lxp1413801/cs66b-redo/电信nbiot平台接入流程.docx

电信nbiot平台接入流程：

1、 开通实验室环境平台账号（已完成）；
2、 编写profile文件以及编解码插件（电信提供技术支持）；
3、 上传编解码插件（电信提供技术支持）；
4、 测试profile和编解码插件（用虚拟设备自测，或者是仪表发送测试数据）；
5、 平台接入测试（电信nbiot上海研究院，远程测试），通过测试后发测试报告；
6、 下载电信平台的北向接口说明书（开通账号的时候可能已经有了），并开发自己服务器（云主机）和app；
7、 如果客户自有的服务器或者是客户自己租用服务器，每个客户单独部署；
8、 客户数据统一由一个服务器托管，通过不同的账号区别每个客户的数据；
