lxp1413801/cs66b-redo/sch/CS66无线扩展板电子元器件清单.xlsx

CS66无线扩展板电子元器件清单
序号 | 型号名称 | 数量 | 位号 | 封装 | 备注
19 | 0Ω贴片电阻 | 2 | R16、C13 | 0603
23 | 10Ω贴片电阻 | 1 | R17 | 0603
25 | 33Ω贴片电阻 | 3 | R13-15 | 0603
21 | 100欧姆贴片电阻 | 4 | R8-9 R24-25 | 0603
24 | 1K贴片电阻 | 4 | R3 R11 R20 R30 | 0603
22 | 10K贴片电阻 | 8 | R4-5 R7 R12 R22 R26-28 | 0603
20 | 100K贴片电阻 | 5 | R2 R10 R19 R21 R29 | 0603
18 | 1Ω贴片电阻 | 2 | R1 R18 | 1206
9 | 30pF贴片电容 | 3 | C7-9 | 0603
5 | 100pF贴片电容 NPO | 2 | C3 C19 | 0603
4 | 0.1uF贴片电容 | 3 | C4-5 C18 | 0603
8 | 1uF贴片电容 10VDC | 2 | C6 C12 | 0603
6 | 10uF贴片电容 16VDC | 4 | C1-2 C16-17 | C1206
14 | 47nH贴片绕线电感 | 1 | L1 | 0603 | 参考型号： B82496C3470G000（TDK）
2 | 场效应管AO3400 | 2 | T2 T4 | SOT23
1 | 场效应管AO4066 | 2 | U6-7 | SOP8
17 | 集成电路,MCP1703T-3302E/MB | 2 | U3 U13 | SOT89
10 | 集成电路CD4066 | 1 | U4 | TSSOP14
13 | 贴片SIM卡 | 1 | U2 | ESIM_MFF2
3 | NBiot模组BC95 | 1 | U1 | BC95
16 | GPS模组L70 | 1 | U5 | L70
11 | 2.54排针6P | 1 | CON2 | SIP-6P
12 | 2.54排针8P | 1 | CON1 | SIP-8P
15 | IPEX射频插座2.0mm | 2 | CON3-4 | IPEX20369 | 参考型号: MM5829-2700（murata）
