lxp1413801/cs66b-redo/sch/CS66.V3.0.SCH.LCD等.dxf

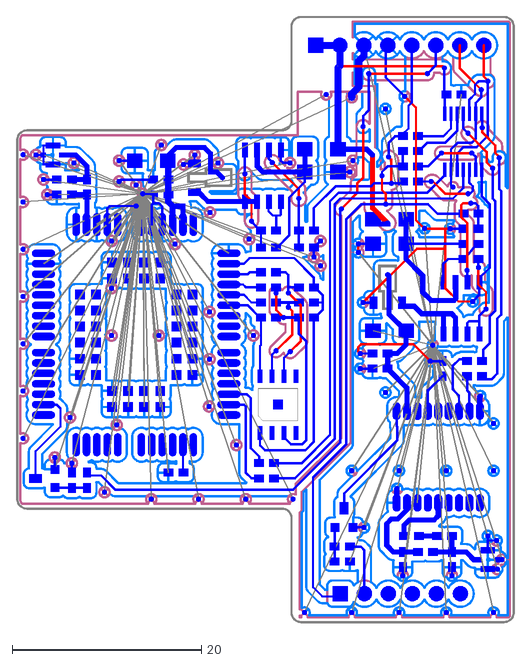
[picture p2: CAD file, 2018-04-26]
sch/CS66.V3.0.SCH.LCD等.dxf
52.7 x 64.2
