lxp1413801/cs66b-redo/sch/pads lib/dxf/esim_mff2.dxf

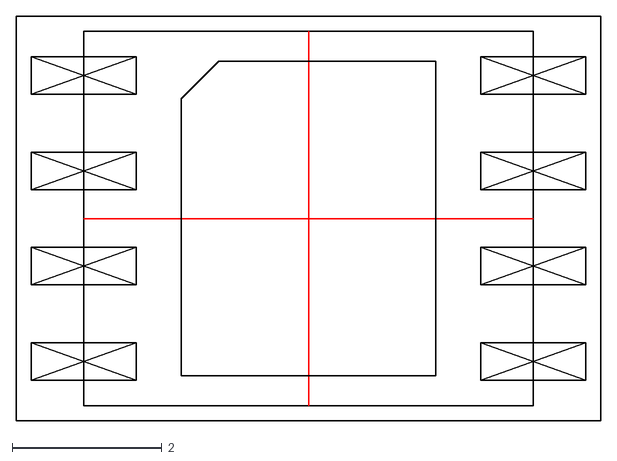
[picture p3: CAD file, 2018-02-05]
sch/pads lib/dxf/esim_mff2.dxf
7.80 x 5.40
