lxp1413801/cs66b-redo/sch/pads lib/dxf/esim.dxf

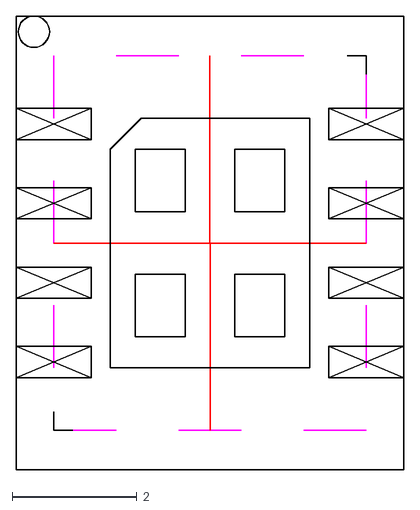
[picture p4: CAD file, 2018-02-02]
sch/pads lib/dxf/esim.dxf
6.20 x 7.27
