lxp1413801/cs66b-redo/sch/pcb out line.dxf

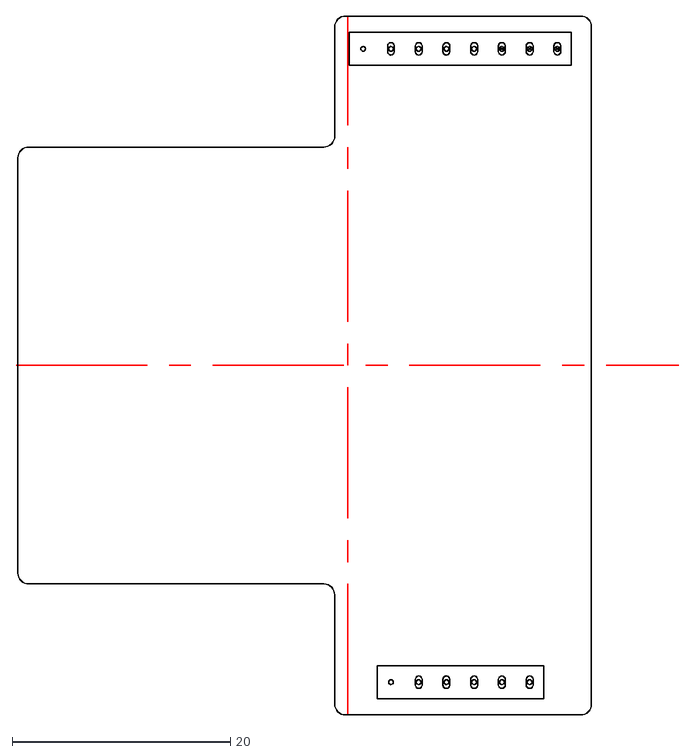
[picture p5: CAD file, 2018-02-08]
sch/pcb out line.dxf
60.7 x 64.0
