lxp1413801/cs66b-redo/sch/pads lib/dxf/ipex20369.dxf

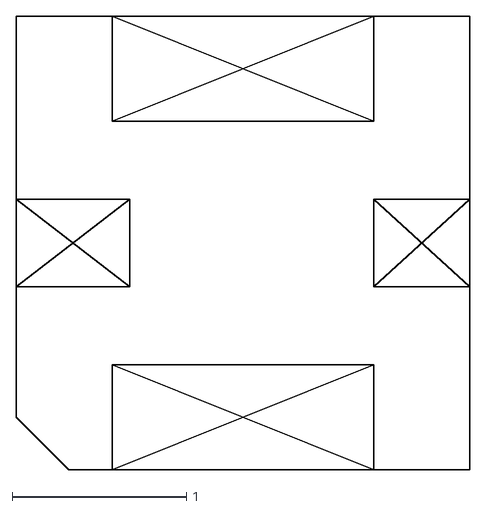
[picture p6: CAD file, 2018-02-02]
sch/pads lib/dxf/ipex20369.dxf
2.60 x 2.60
