lxp1413801/cs66b-redo/sch/CS66.ZB.V3.0.dxf

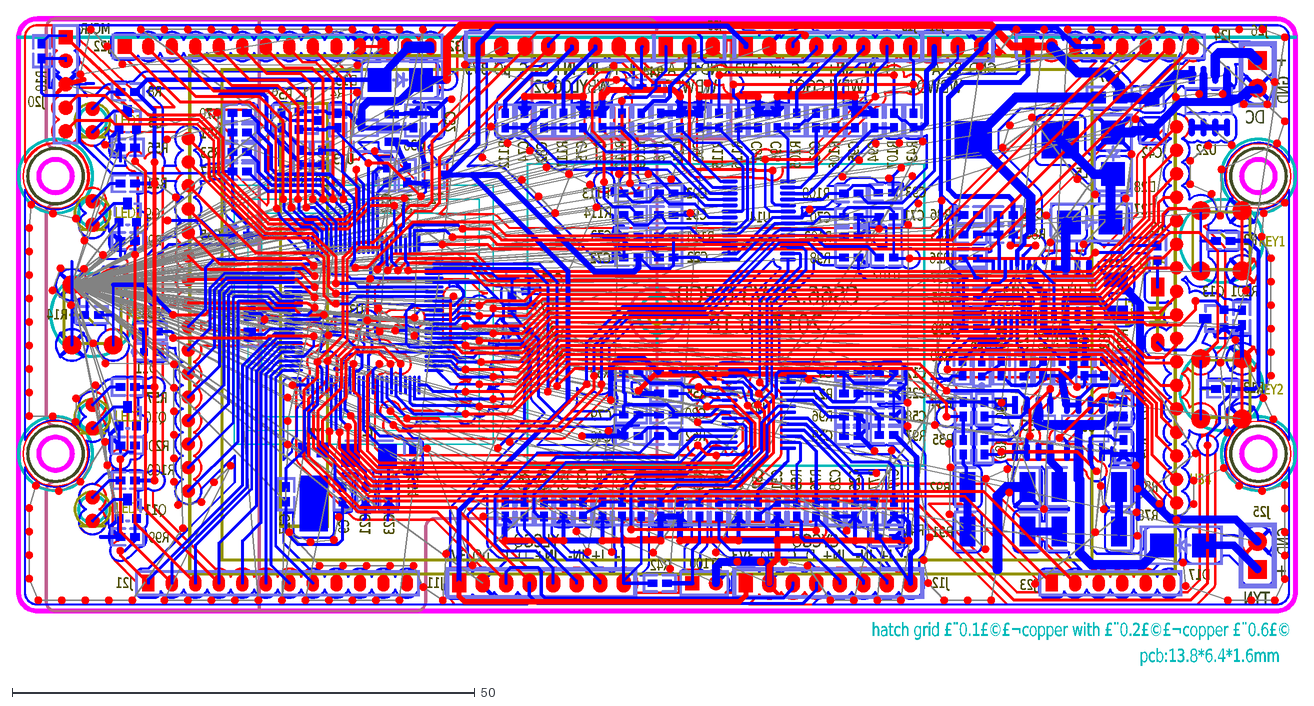
[picture p7: CAD file, 2018-02-05]
sch/CS66.ZB.V3.0.dxf
hatch grid （0.1），copper with （0.2），copper （0.6）
pcb:13.8*6.4*1.6mm
CS66.ZB.V3.0.PCB
2017.10.18
CYCGQ
YLCGQ
WBWD2
背光
TYN
DC
+
GND
MCLR
3V3
地
C
D
IN+
IN-
I+
I-
WBYLCGQ2
WBYLCGQ1
WBWD1
A
B1
LED3
LED2
LED1
LED4
KEY3
LED5
U34
KEY2
KEY1
Y1
R18
J20
R14
J22
R99
R100
R20
R57
R9
R11
R56
R8
Q11
Q10
Q9
Q3
J21
D11
R31
C45
R17
R53
R61
R70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
