lxp1413801/cs66b-redo/sch/pcb out line_v101.dxf

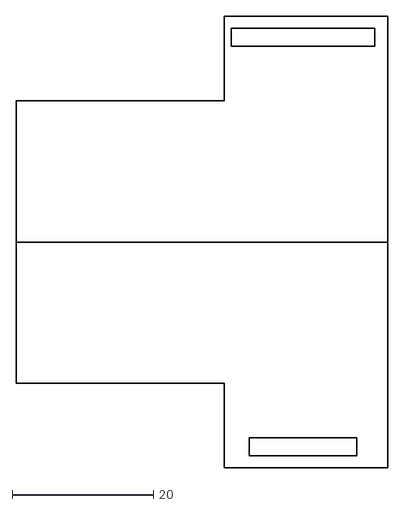
[picture p8: CAD file, 2018-02-06, an earlier design]
sch/pcb out line_v101.dxf
52.7 x 64.0
