lxp1413801/cs66b-redo/CS66.V3.3.SCH.pdf

D

6 | 5 | 4 | 2 | 1

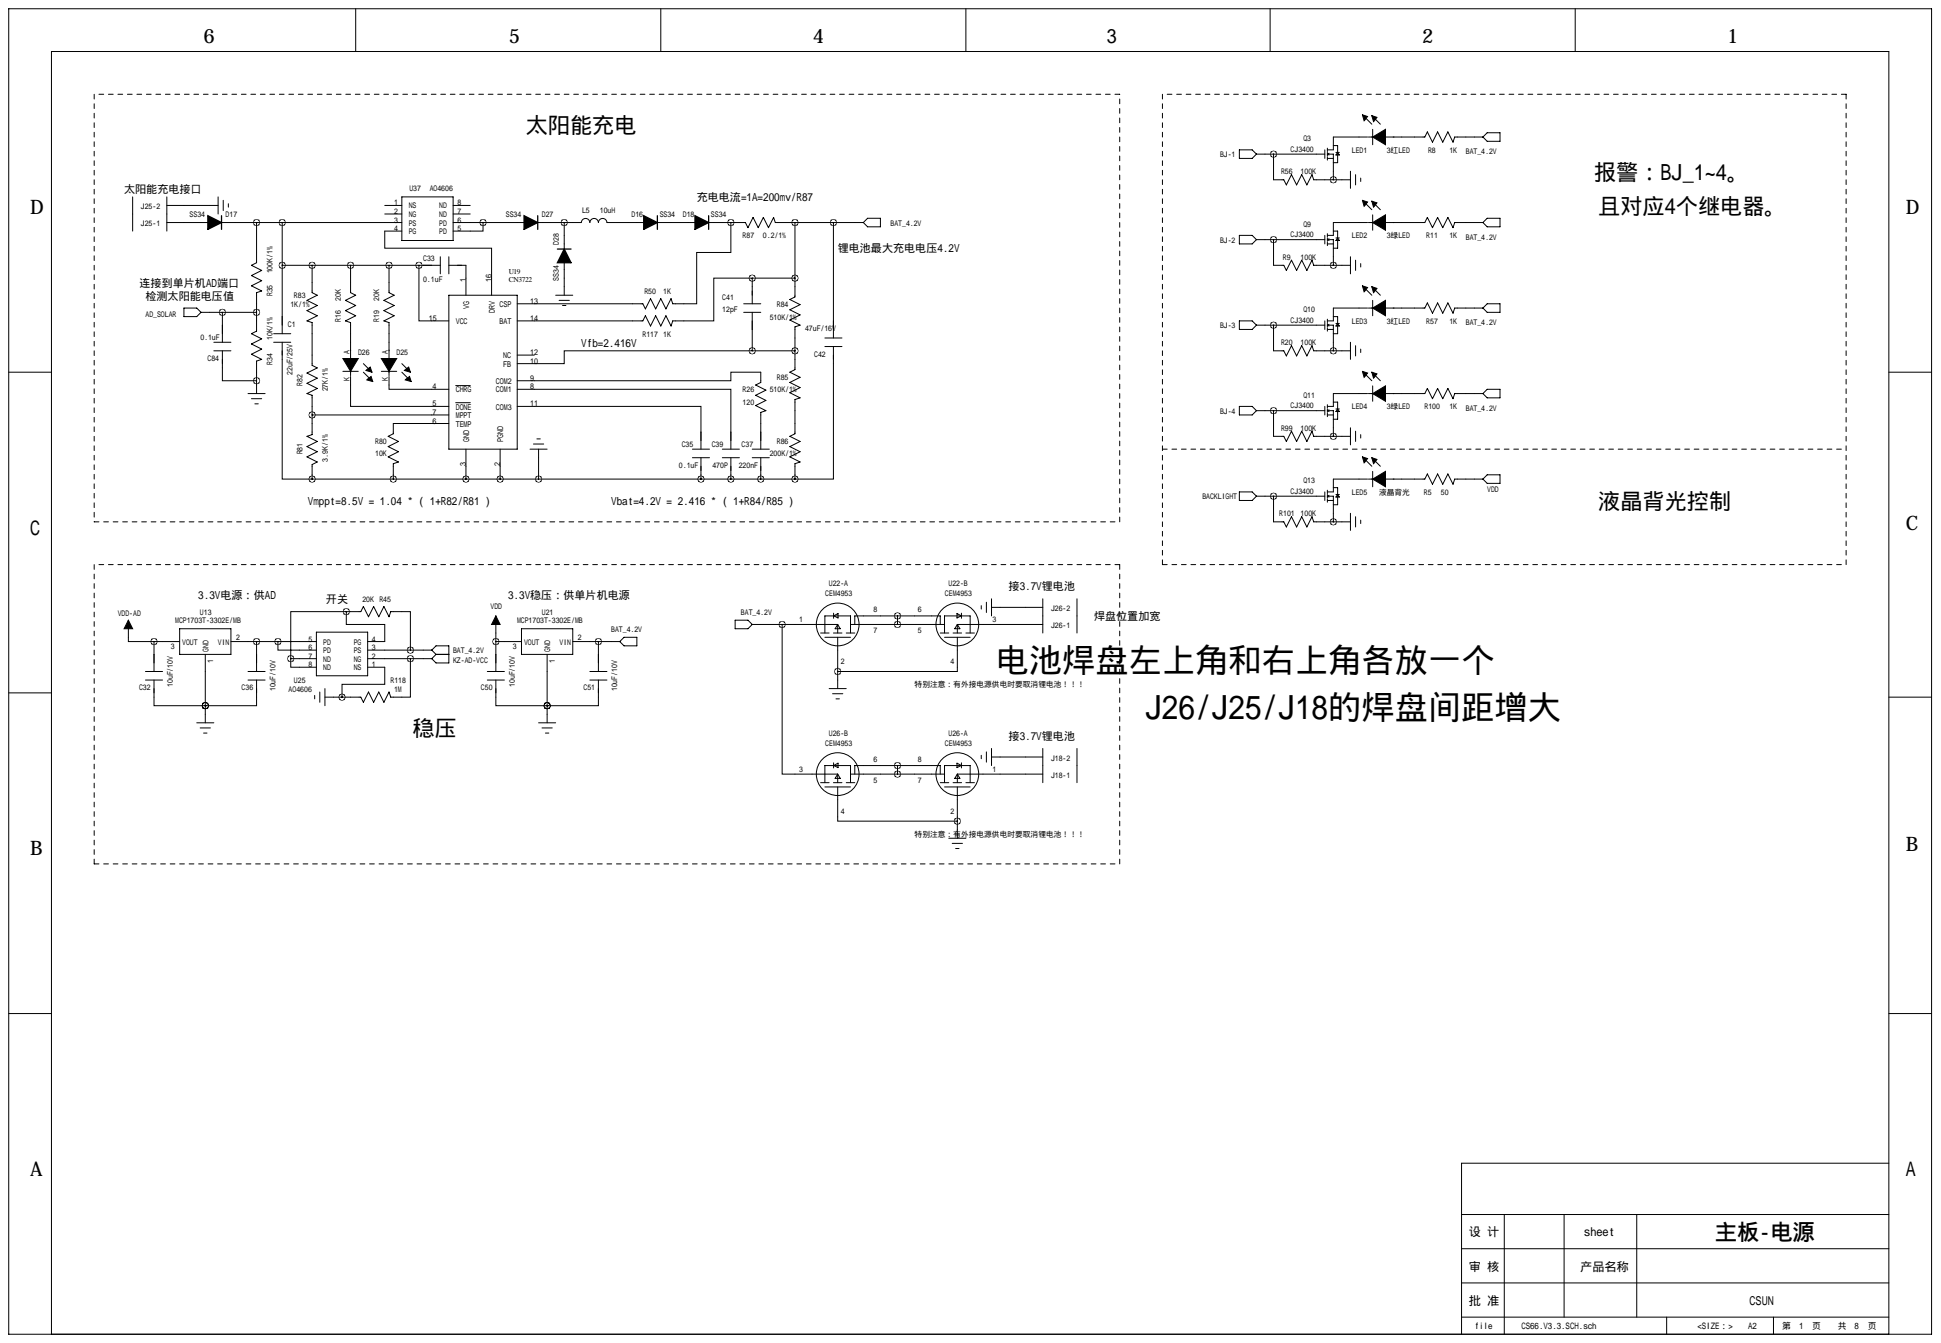
[picture p9: page 1]

设 计 | | sheet | 主板-电源

审 核 | | 产品名称

批 准 | | | CSUN

file | CS66.V3.3.SCH.sch | <SIZE：> A2 | 第 页 共 页

D

D

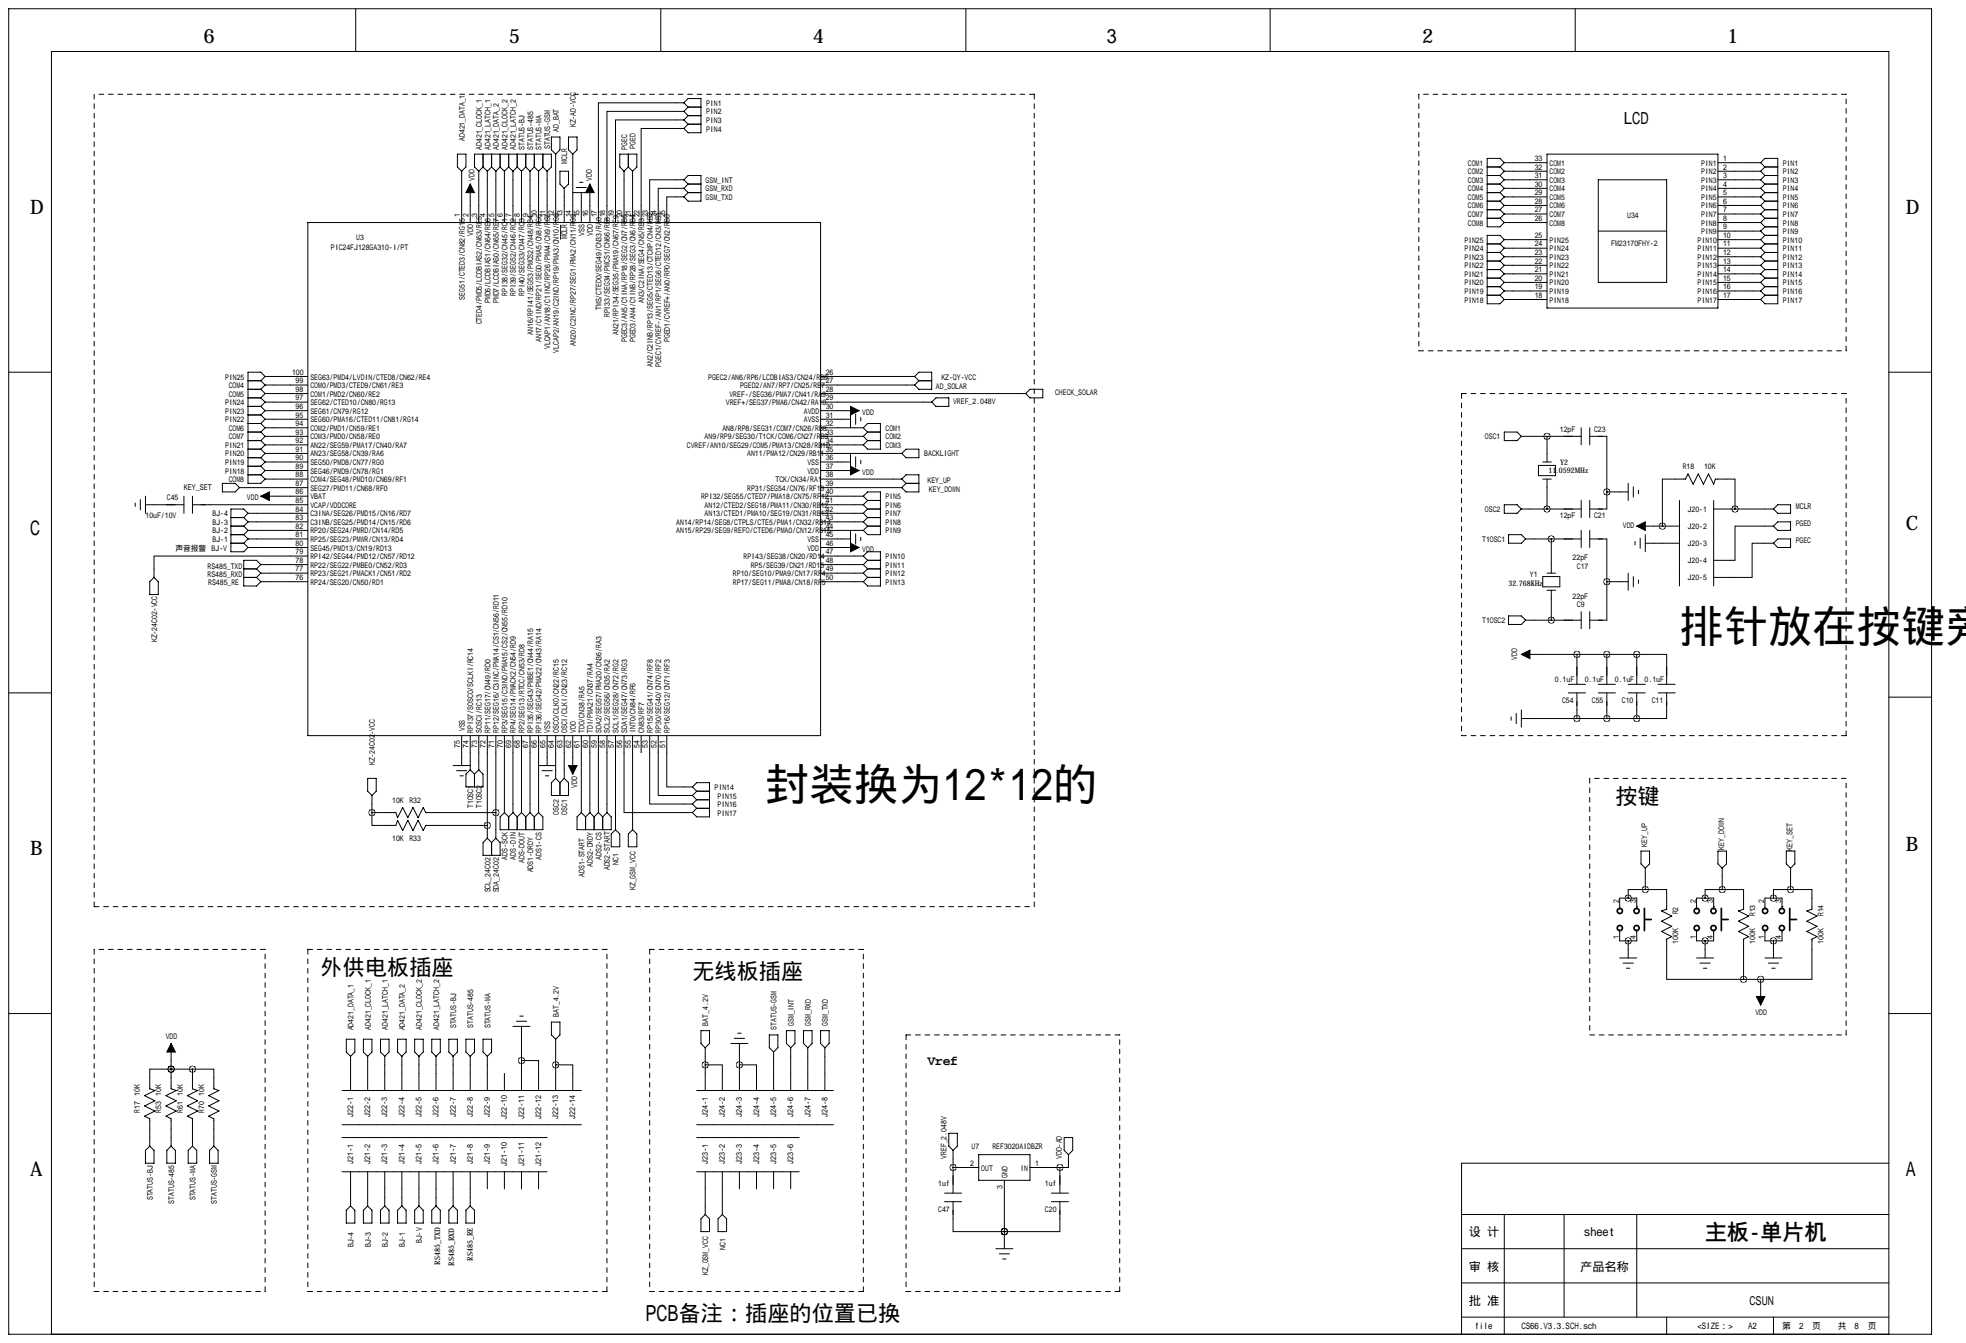
[picture p10: page 2]

D

D

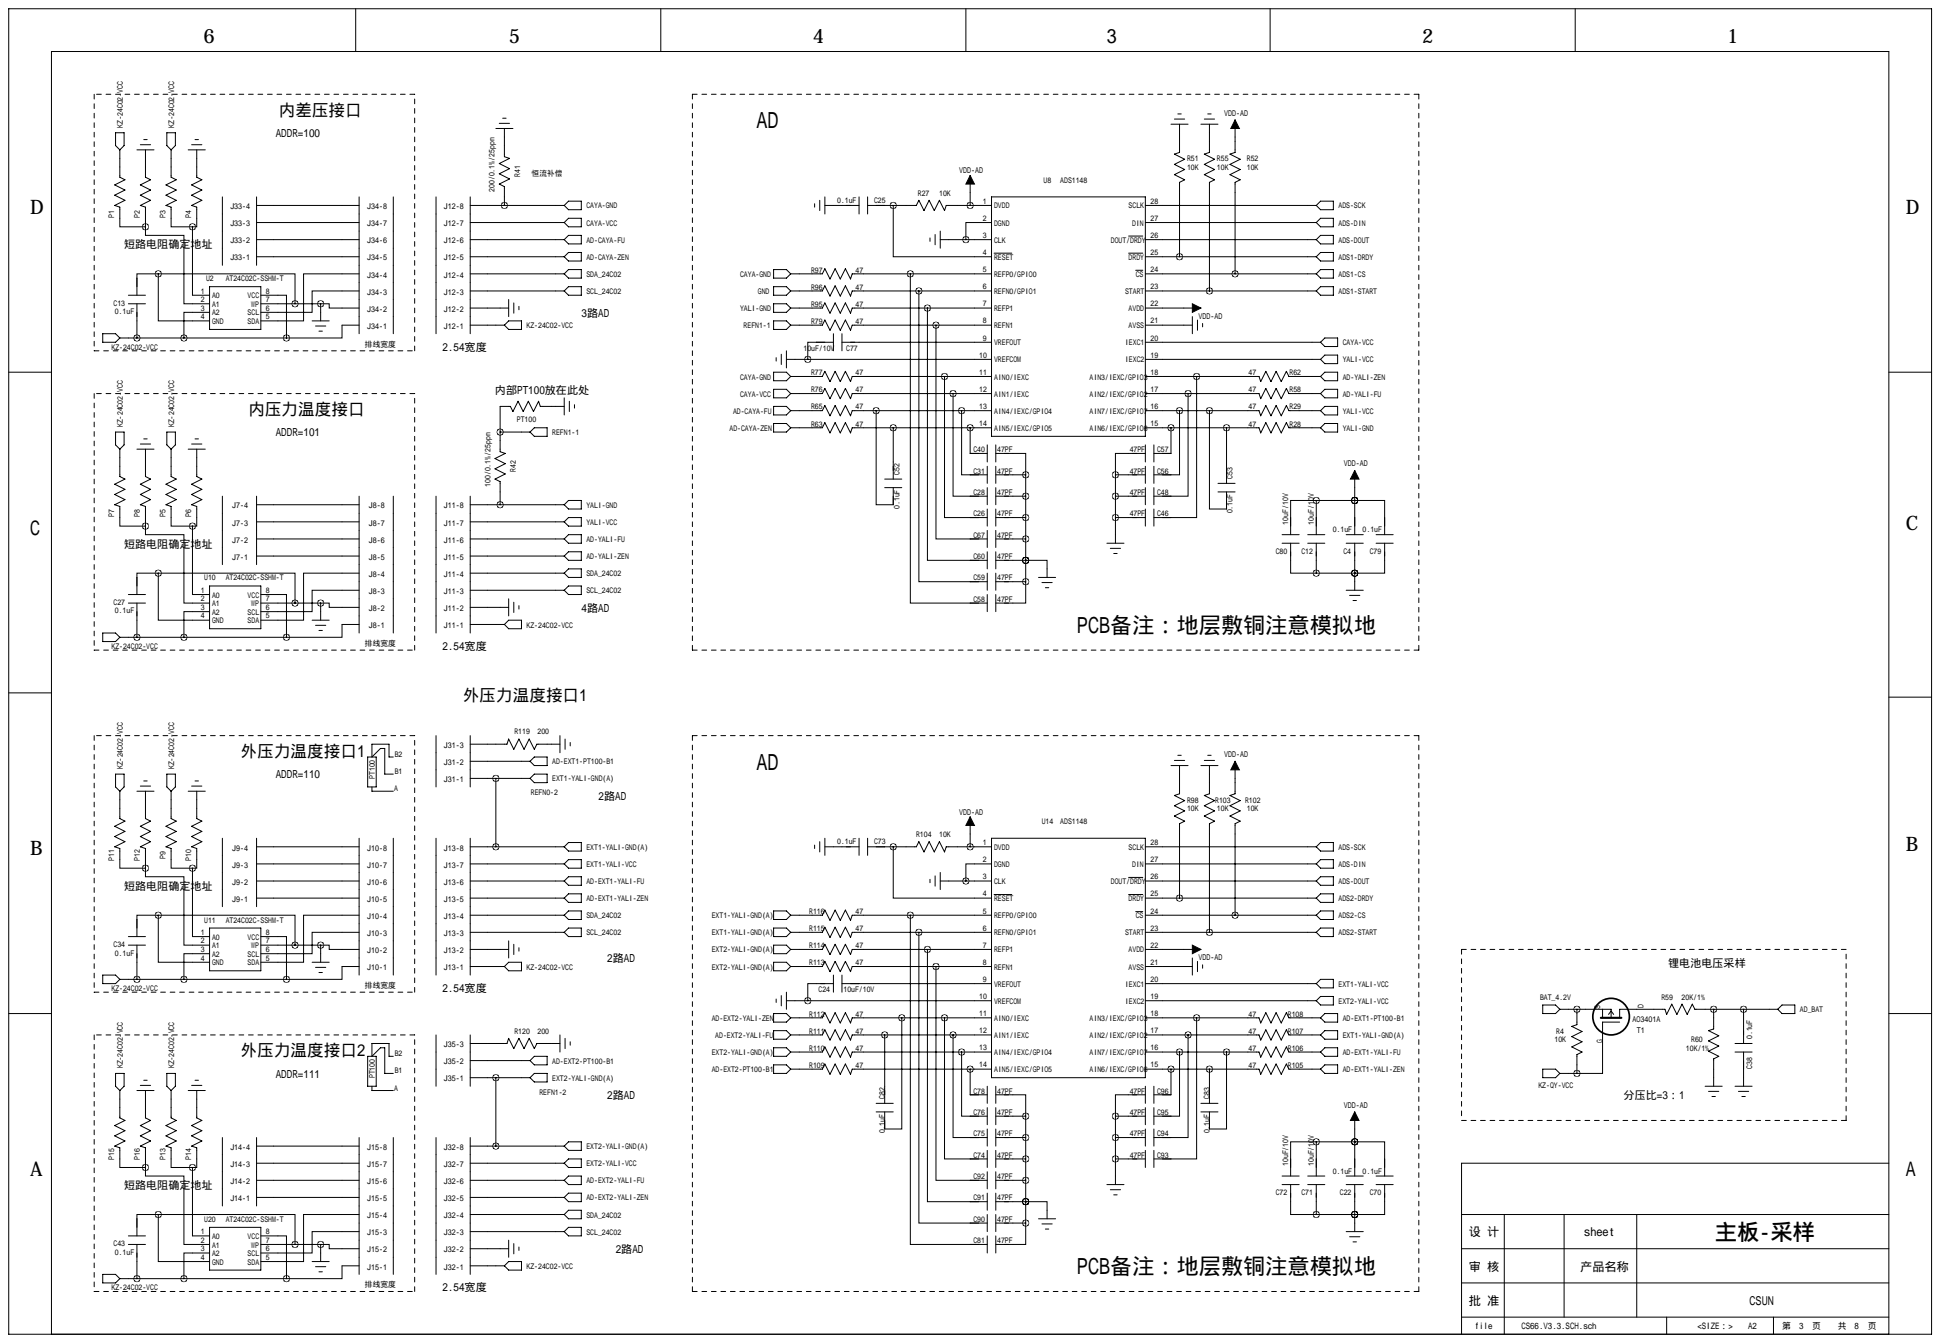
[picture p11: page 3]

D

D

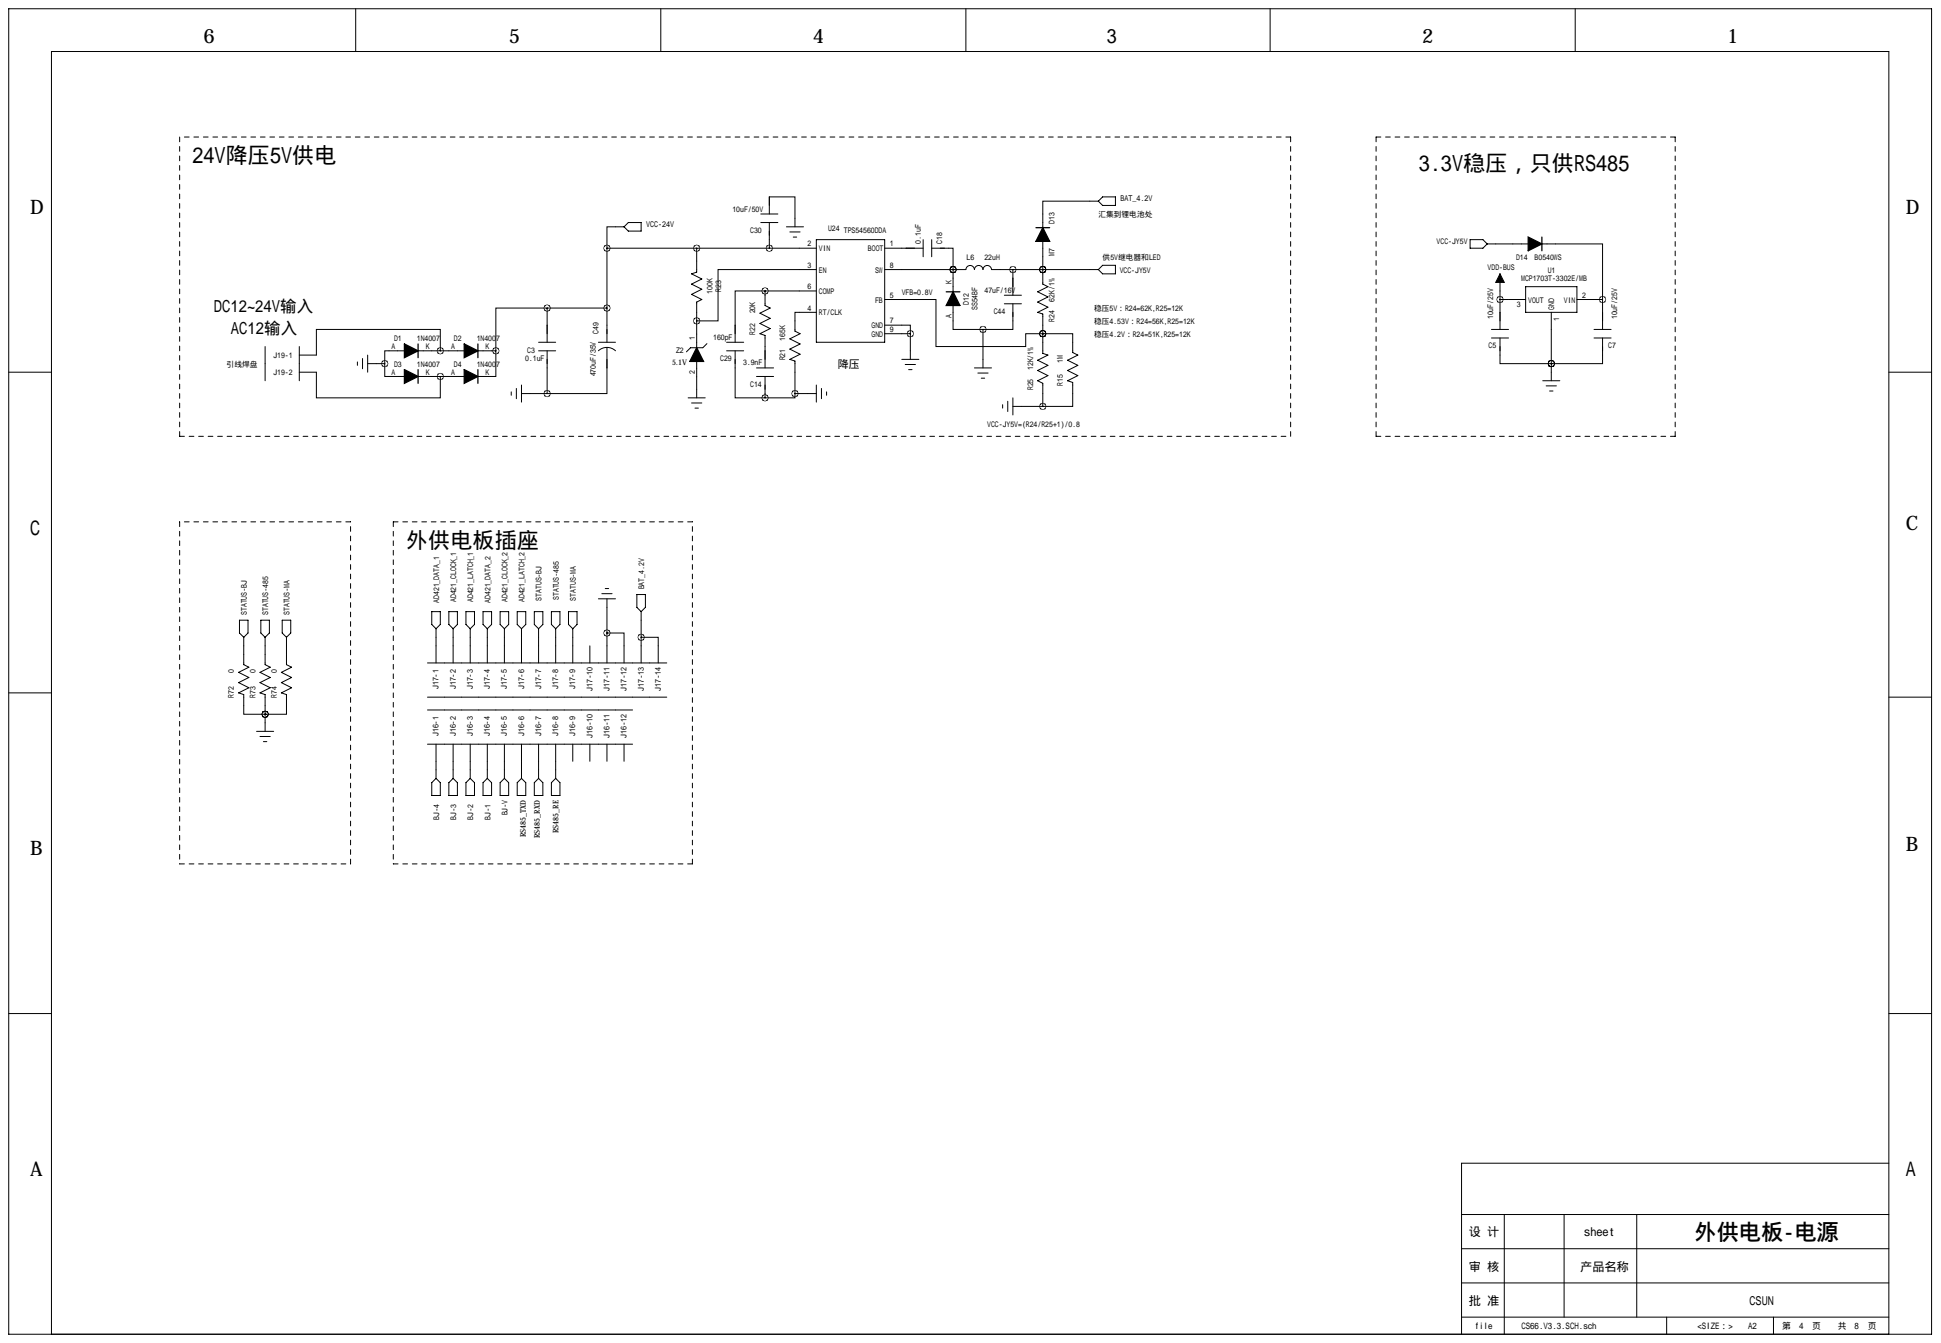
[picture p12: page 4]

D

D

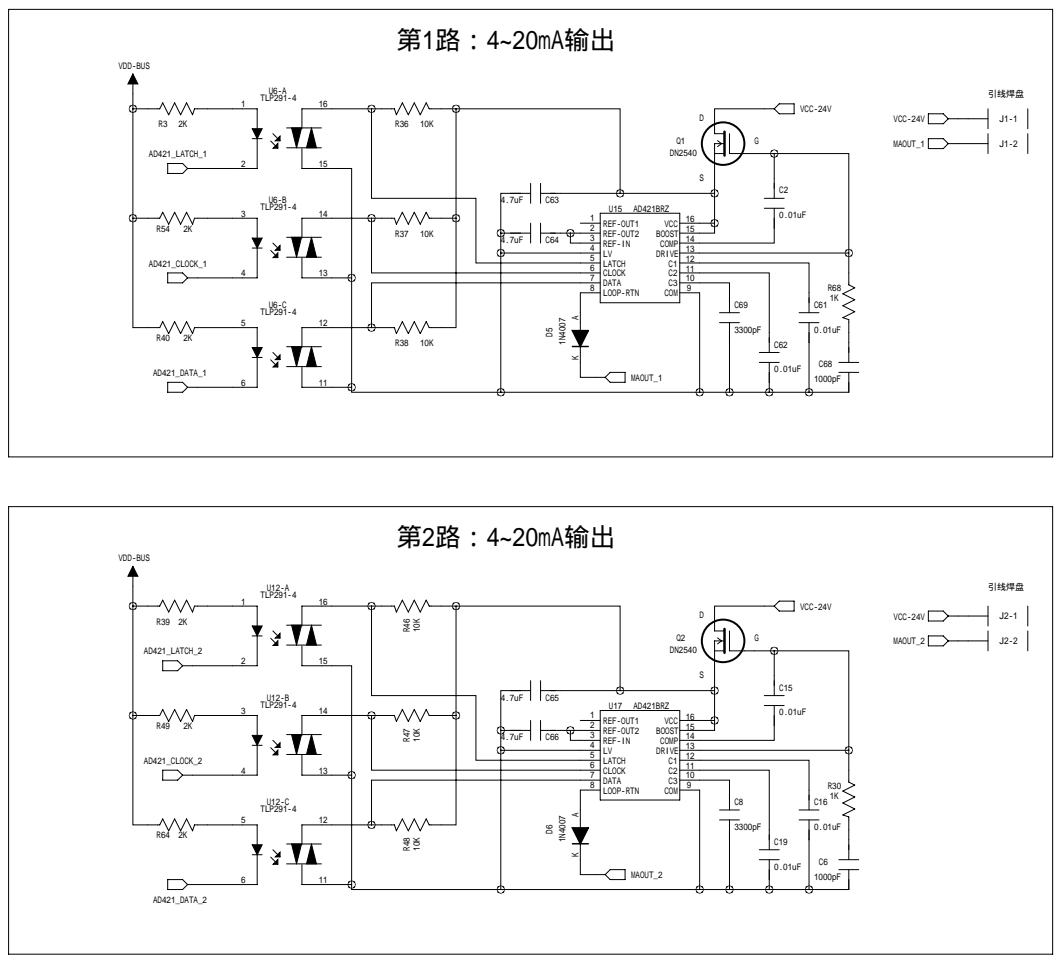
[picture p13: page 5]

D

D

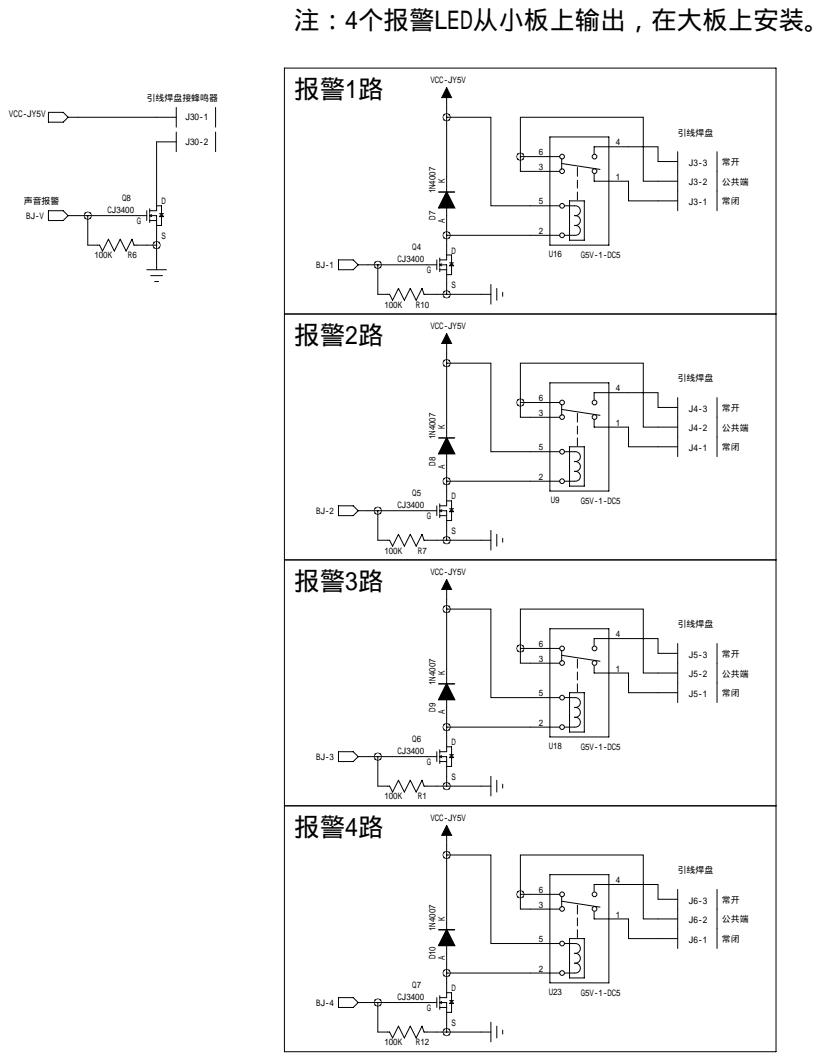
[picture p14: page 6]

D

D

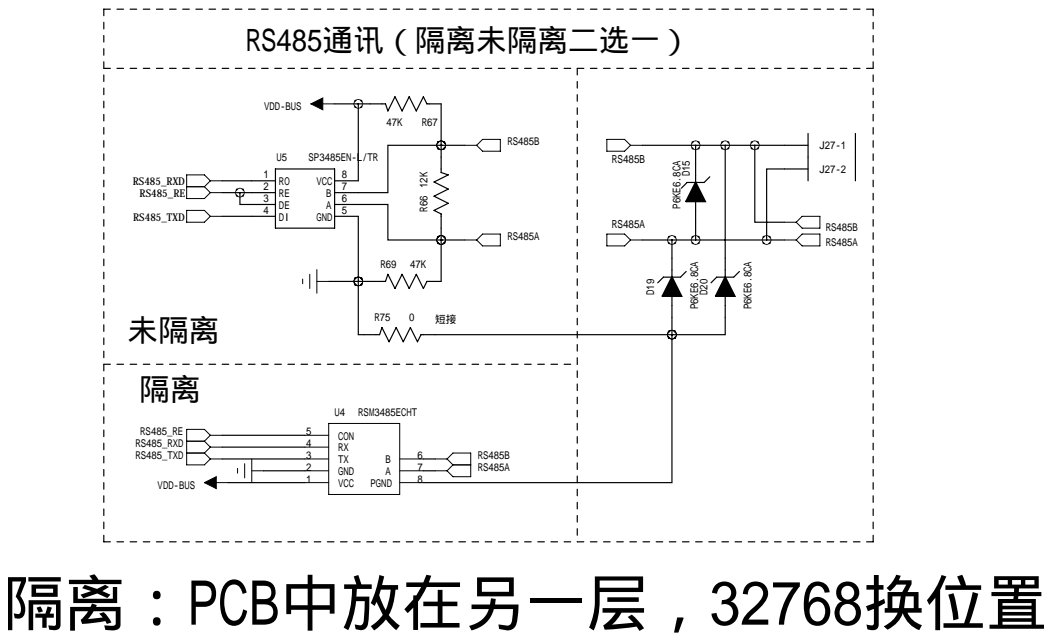
[picture p15: page 7]
sheet; 外供电板-485; RS485通讯（隔离未隔离二选一）; 未隔离; 隔离：PCB中放在另一层，32768换位置; VCC; GND; CON; PGND; RSM3485ECHT; VDD-BUS; RS485_RE RS485_RXD RS485_TXD; RS485_TXD; RS485_RXD

D

D

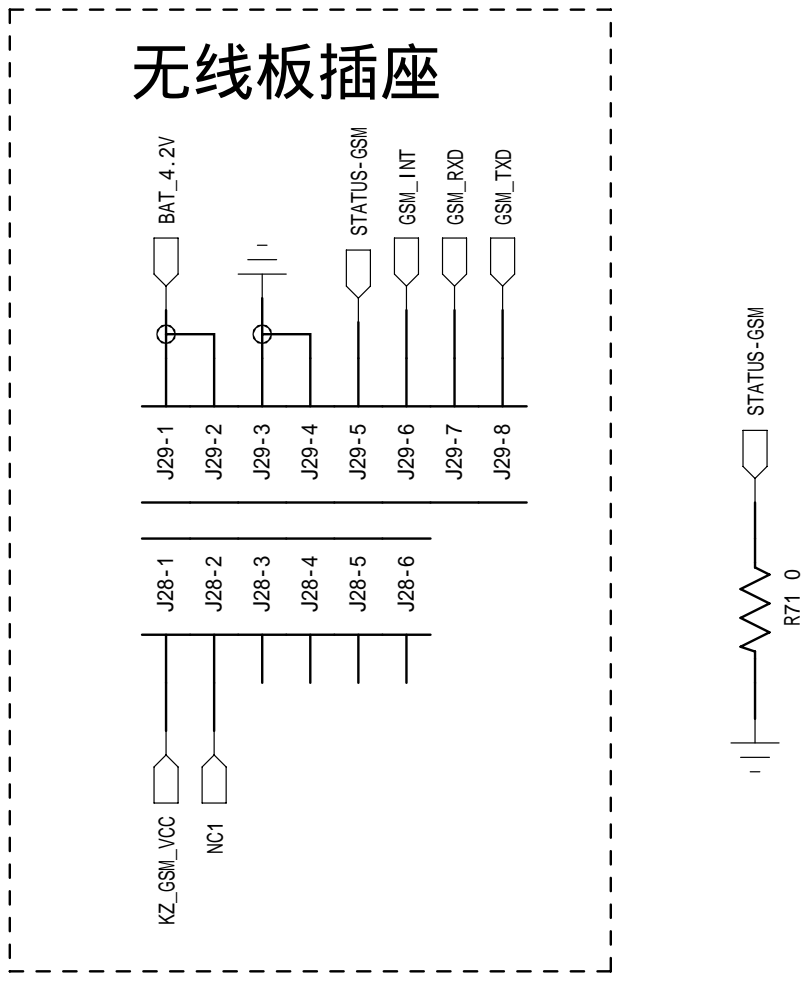
[picture p16: page 8]
sheet; 无线板-GPRS; 无线板插座
