lxp1413801/cs66b-redo/sch/CS66.V3.0.SCH.LCD等.pdf

D

6 | 5 | 4 | 3 | 2 | 1

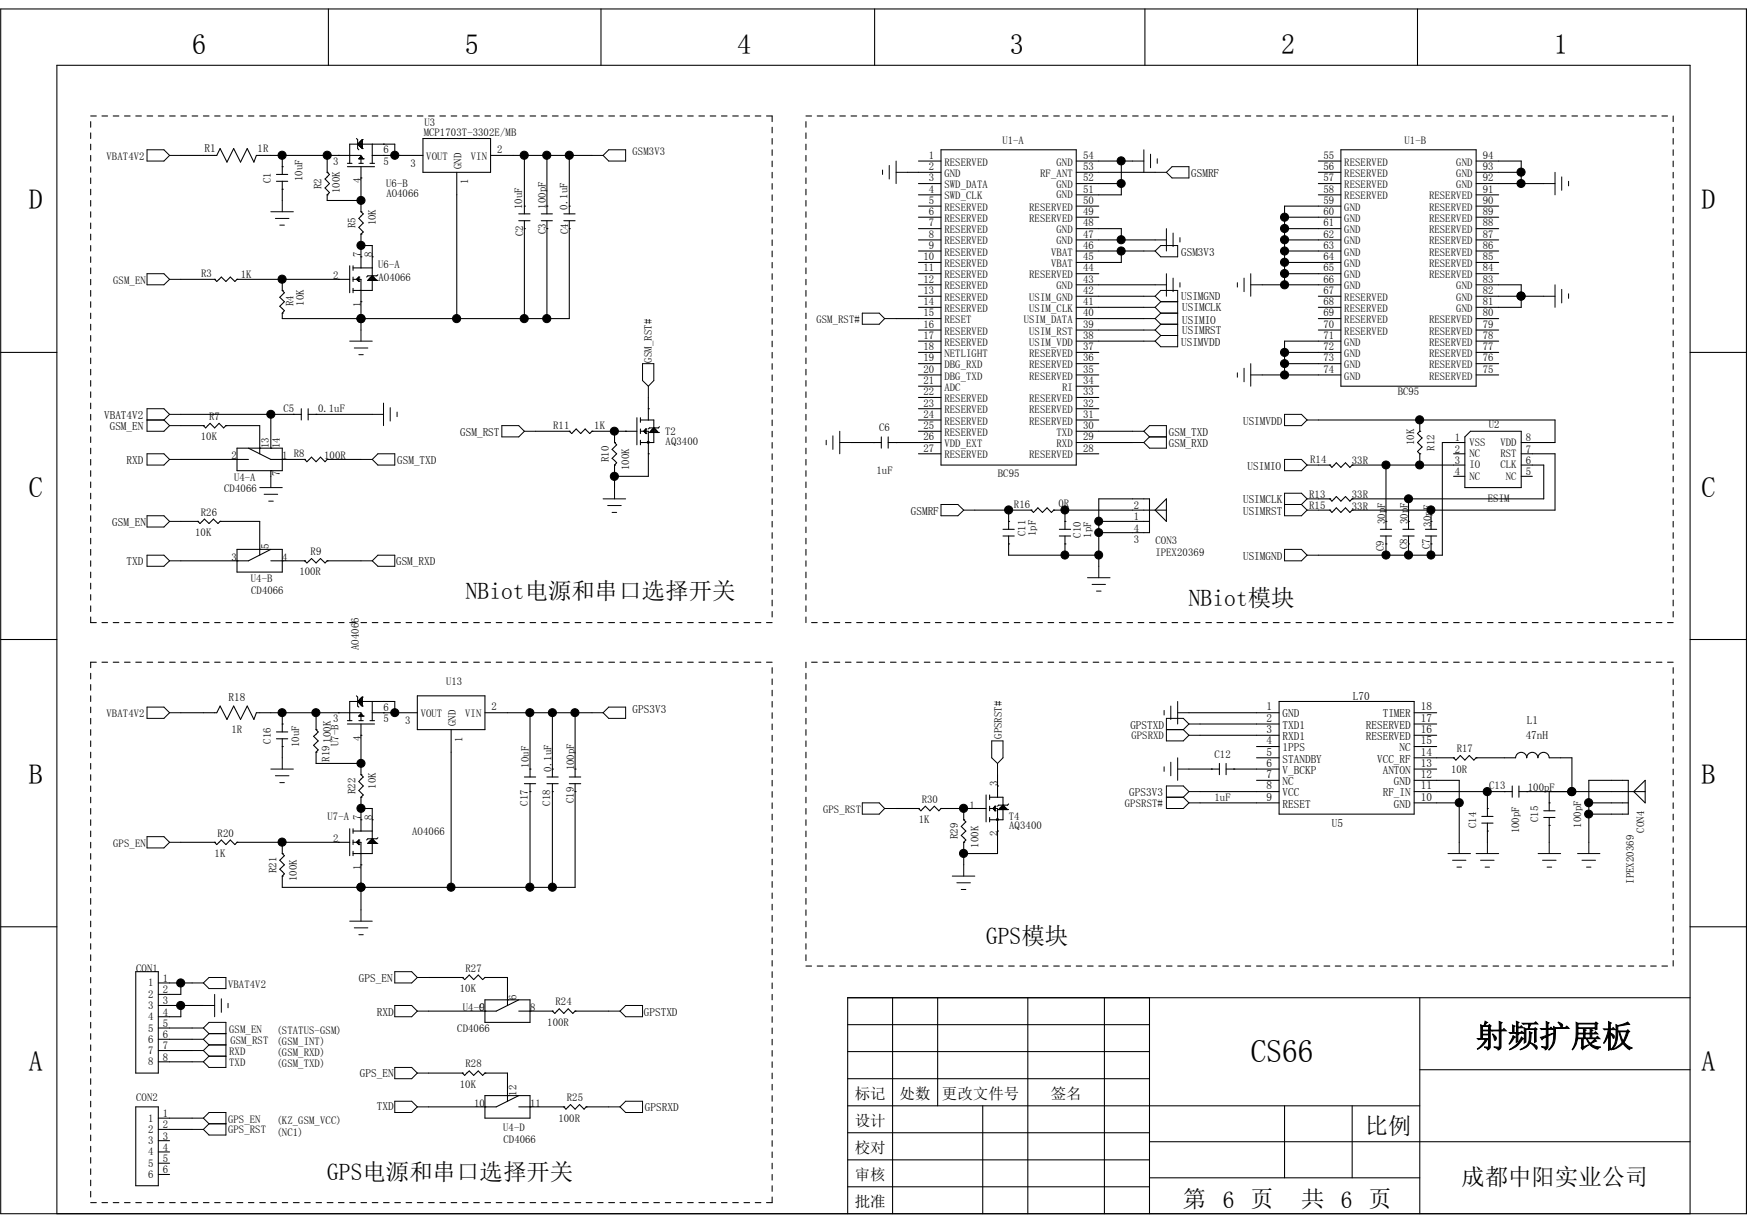
[picture p24: page 1]

校对
审核
批准

成都中阳实业公司
