lxp1413801/cs66b-redo/sch/CS66.V3.0.SCH.LCD等pcb.pdf

# C5C⁵x1 C⁵x2


CON2 CON²x1 CON²x2 CON²x3 CON²x4 CON²x5 CON²x6; CON1 CON¹x1 CON¹x2 CON¹x3 CON¹x4 CON¹x5 CON¹x6 CON¹x7 CON¹x8

C5

# C5C⁵x1 C⁵x2



1 | 2 | 3 | 4 | 5 | 6 | 7 | 8
1 | 2

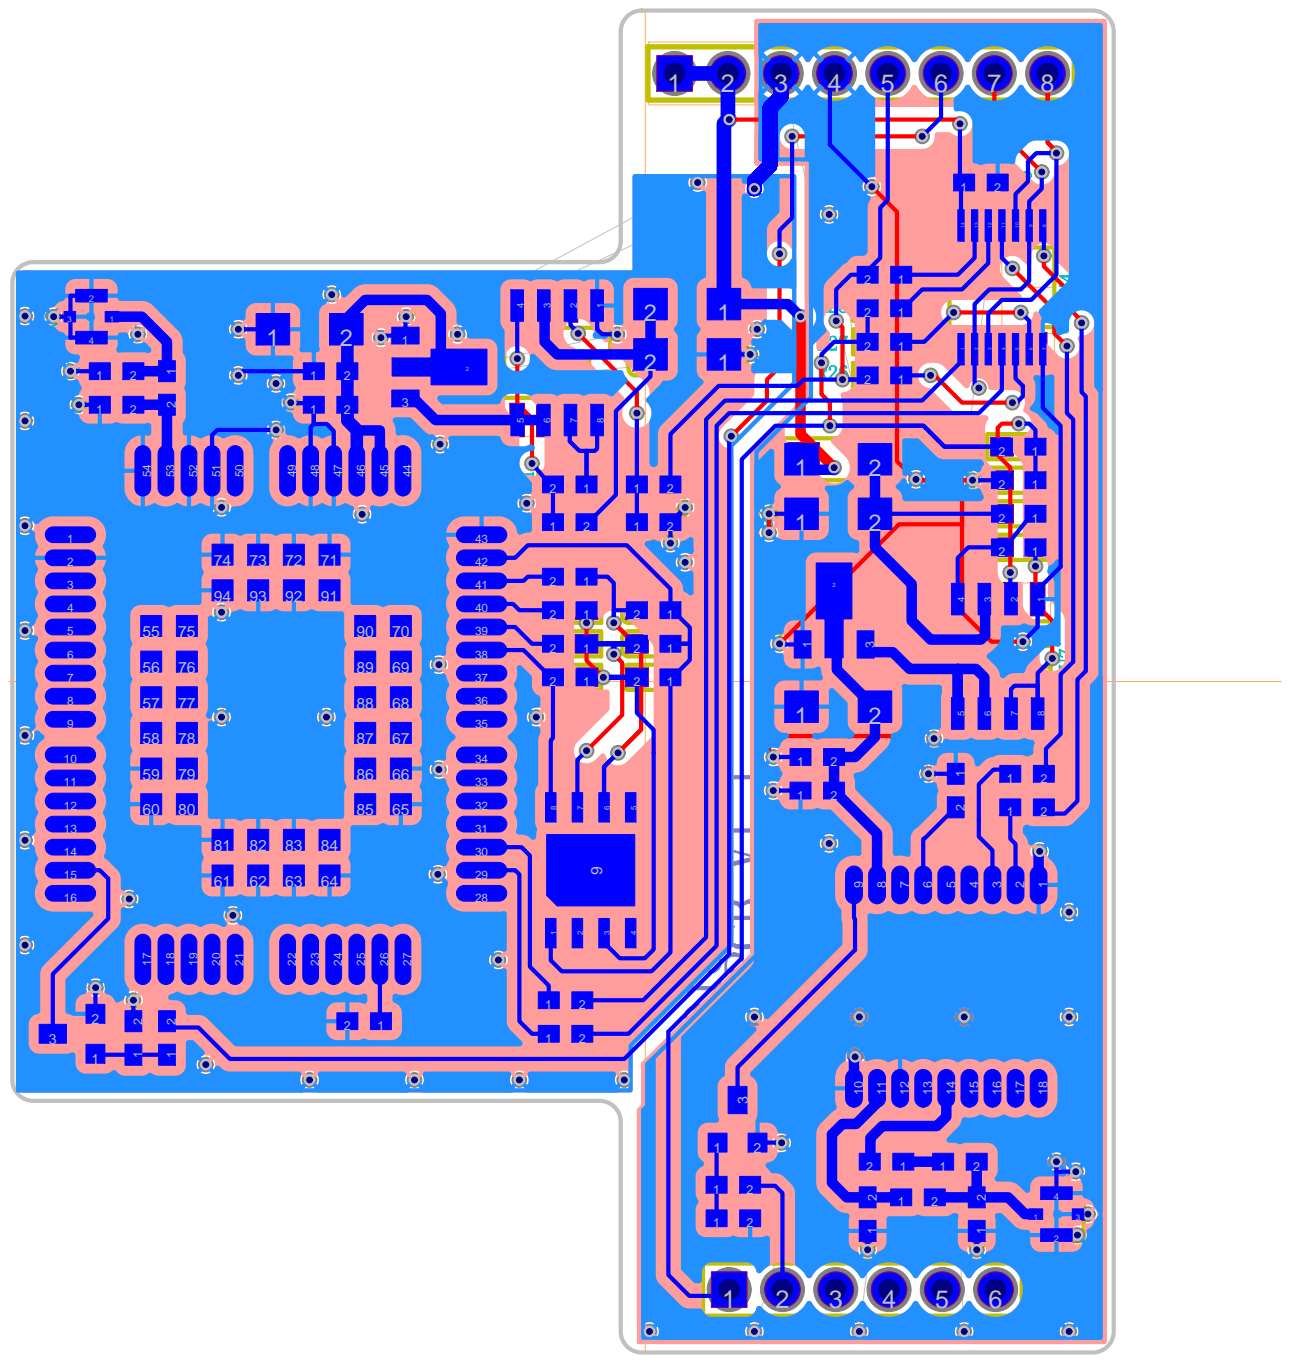
[picture p25: page 5]

C11C¹¹x1 C11C¹¹x1 C11C¹¹x1 | C¹¹x2 C¹¹x2 C¹¹x2 | C4C⁴x1 C4C⁴x1 C4C⁴x1 | C⁴x2 C⁴x2 C⁴x2 2

C5

# CON1

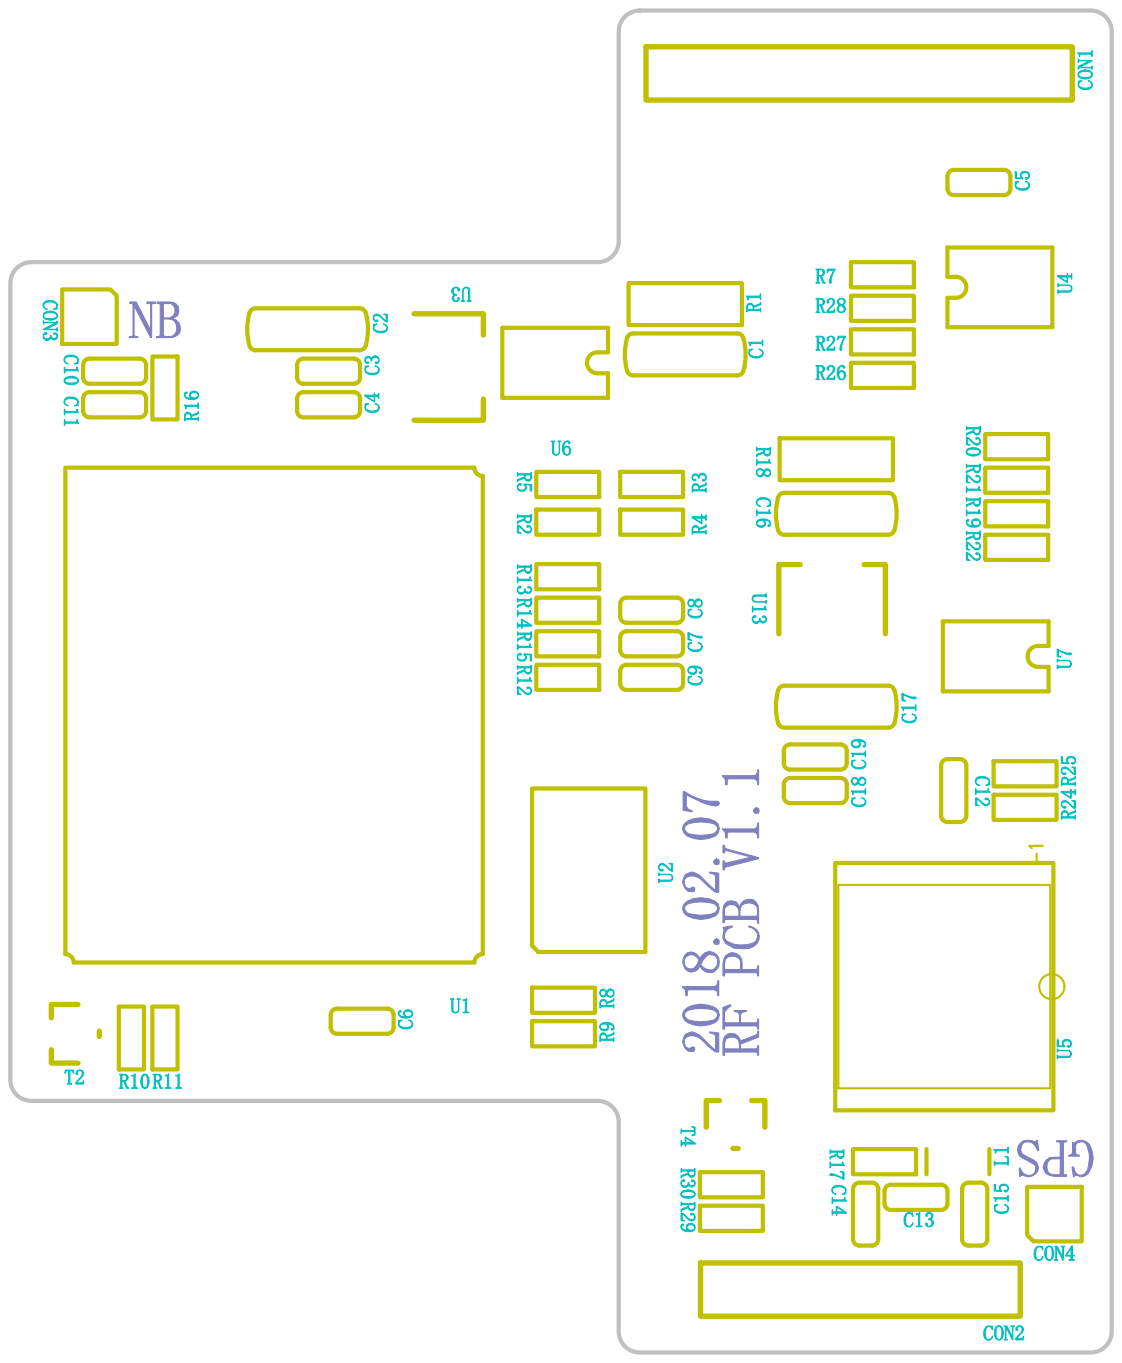
[picture p26: page 6]

# C5C⁵x1 C⁵x2
