lxp1413801/cs66b-redo/sch/cs66射频扩展板尺寸图.pdf

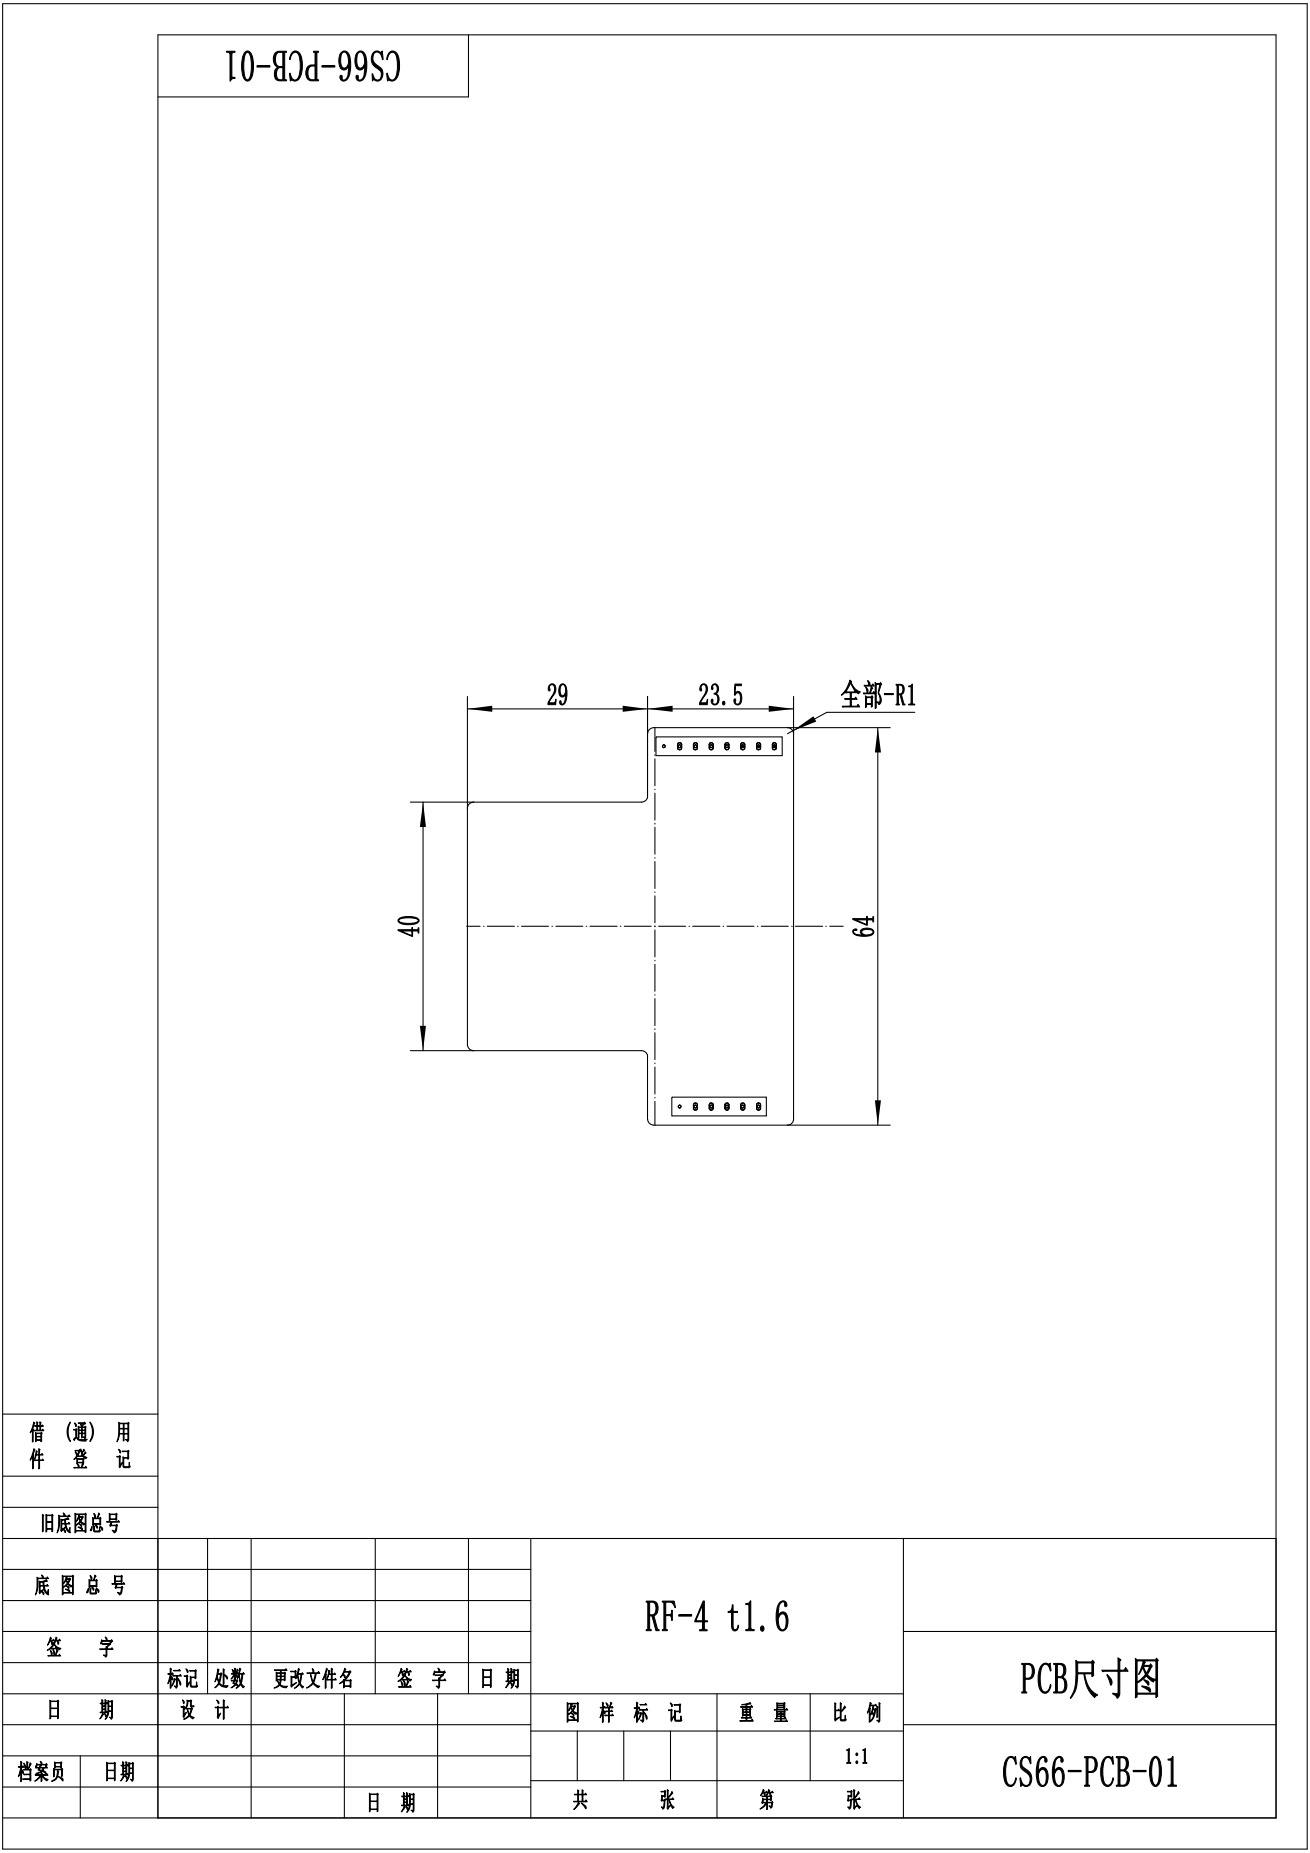
[picture p27: page 1]
