lxp1413801/cs66b-redo/(list of files, drawings)

Other design files:
sch/CS66.V3.0.SCH.LCD等.pcb
