lxp1413801/cs66b-redo/src/driver/drivers.h

//file name :drivers.h
#ifndef __drivers_h__
#define __drivers_h__
#ifdef __cplusplus
	extern "C"{
#endif
	#include "../../mcc_generated_files/mcc.h"
    #include <stdint.h>
	#include "gpio_config.h"
	#include "gpio.h"
    #include "lcd.h"
	#include "ads1148_hal.h"
	#include "ads1148.h"
	#include "i2c.h"
	#include "ex_eeprom.h"
	#include "key.h"
	#include "ad421.h"
	

#ifdef __cplusplus
	}
#endif

#endif
//file end
