lxp1413801/cs66b-redo/src/driver/ads1148.c

#include "drivers.h"
#include "../soc/delay.h"
#include "../soc/ticker.h"
#include "ads1148.h"
#include "float.h"
#include "../api/api.h"

// #include "../../os_configs/FreeRTOSConfig.h"
// #include "../../os_kernel/include/FreeRTOS.h"
// #include "../../os_kernel/include/task.h"  
#include "../global/globle.h" 

ads1148Obj_t ads1148Chip0,ads1148Chip1;
ads1148PinsSta_t allAds1148PinsSta=ADS1148_PINS_UNINIT;

uint8_t ads1148_send_cmd(ads1148Obj_t* obj,uint8_t cmd)
{
    uint8_t ret;
	#if ADS1148_SCK_IDLE_STATUE==0
    obj->pins_sck_set_low();
	#else
	obj->pins_sck_set_hight();
	#endif
//delay_us(10);
	obj->pins_cs_set_low();
    ret=obj->ads1148_write_read_via_spi(cmd);
	delay_us(10);
	obj->pins_cs_set_hight();
	delay_us(10);
    return ret;
}

volatile uint16_t ads1148_read_data(ads1148Obj_t* obj)
{
	volatile uint16_t t16=0;
	uint8_t t8=0;
	#if ADS1148_SCK_IDLE_STATUE==0
    obj->pins_sck_set_low();
	#else
	obj->pins_sck_set_hight();
	#endif
//    delay_us(10);
	obj->pins_cs_set_low();
	obj->ads1148_write_read_via_spi(ADS1148_CMD_RDATA);
    delay_us(5);
	t8=obj->ads1148_write_read_via_spi(ADS1148_CMD_NOP);
	t16=t8;
	t16<<=8;
    delay_us(5);
	t8=obj->ads1148_write_read_via_spi(ADS1148_CMD_NOP);
	t16 |= t8;
    delay_us(10);
	obj->pins_cs_set_hight();
	delay_us(10);
	return t16;
}

void ads1148_write_register(ads1148Obj_t* obj,uint8_t offsetaddr,uint8_t *buf,uint8_t num)
{
	uint8_t i;
	uint8_t cmd;
	if(num<1)return;
	#if ADS1148_SCK_IDLE_STATUE==0
    obj->pins_sck_set_low();
	#else
	obj->pins_sck_set_hight();
	#endif
//delay_us(10);
	obj->pins_cs_set_low();
	cmd=ADS1148_CMD_WREG;
	cmd |= (offsetaddr & 0x0f);
	obj->ads1148_write_read_via_spi(cmd);
	obj->ads1148_write_read_via_spi(num-1);
	for(i=0;i<num;i++){
		obj->ads1148_write_read_via_spi(*buf);
		buf++;
	}
    delay_us(10);
	obj->pins_cs_set_hight();
	delay_us(10);
}

void ads1148_read_register(ads1148Obj_t* obj,uint8_t offsetaddr,uint8_t *buf,uint8_t num)
{
	uint8_t t8;
	uint8_t i;
	uint8_t cmd;
	if(num<1)return;
	#if ADS1148_SCK_IDLE_STATUE==0
    obj->pins_sck_set_low();
	#else
	obj->pins_sck_set_hight();
	#endif
//delay_us(10);
	obj->pins_cs_set_low();
	cmd=ADS1148_CMD_RREG;
	cmd |= (offsetaddr & 0x0f);
	t8=obj->ads1148_write_read_via_spi(cmd);
	t8=obj->ads1148_write_read_via_spi(num-1);
	for(i=0;i<num;i++){
		*buf=obj->ads1148_write_read_via_spi(ADS1148_CMD_NOP);
		buf++;
	}
	//obj->pins_sck_set_hight();
	delay_us(10);
	obj->pins_cs_set_hight();
	delay_us(10);
}
//api
void ads1148_slef_calibration(ads1148Obj_t* obj)
{
	#if ADS1148_SCK_IDLE_STATUE==0
    obj->pins_sck_set_low();
	#else
	obj->pins_sck_set_hight();
	#endif
//delay_us(10);
	obj->pins_cs_set_low();
	obj->ads1148_write_read_via_spi(ADS1148_CMD_SYSOCAL);
	delay_ms(300);//bug
	obj->pins_cs_set_hight();
	delay_us(10);
}

void ads1148_set_channle_normal(ads1148Obj_t* obj,uint8_t chp,uint8_t chn)
{
    uint8_t tmp,i;
	st_ads1148RegMUX0 mux0Temp;

	//mux0Temp.mux0=obj->ads1148Regs.regs.regMUX0.mux0;
	ads1148_read_register(obj,ADS1148_REG_ADDR_MUX0,(uint8_t*)&mux0Temp,1);
    mux0Temp.bits.mux_sp=chp;
    mux0Temp.bits.mux_sn=chn;
    //obj->ads1148Regs.regs.regMUX0.mux0=mux0Temp.mux0;
    i=5;
    do{
        ads1148_write_register(obj,ADS1148_REG_ADDR_MUX0,(uint8_t*)&mux0Temp,1);
        ads1148_read_register(obj,ADS1148_REG_ADDR_MUX0,(uint8_t*)&tmp,1);
        if(tmp==mux0Temp.mux0)break;
    }while(i--);
    

}
void ads1148_set_bcs(ads1148Obj_t* obj,uint8_t bcs)
{
    uint8_t tmp,i;
	st_ads1148RegMUX0 mux0Temp;
	//mux0Temp.mux0=obj->ads1148Regs.regs.regMUX0.mux0;
	ads1148_read_register(obj,ADS1148_REG_ADDR_MUX0,(uint8_t*)&mux0Temp,1);
    mux0Temp.bits.bcs=bcs;

    //obj->ads1148Regs.regs.regMUX0.mux0=mux0Temp.mux0;
    i=5;
    do{
        ads1148_write_register(obj,ADS1148_REG_ADDR_MUX0,(uint8_t*)&mux0Temp,1);
        ads1148_read_register(obj,ADS1148_REG_ADDR_MUX0,(uint8_t*)&tmp,1);
        if(tmp==mux0Temp.mux0)break;
    }while(i--);
}

void ads1148_set_vbias(ads1148Obj_t* obj,uint8_t vbias)
{
    uint8_t t8;
    t8=vbias;
    ads1148_write_register(obj,ADS1148_REG_ADDR_VBIAS,(uint8_t*)&t8,1);
	
}

void ads1148_set_vref(ads1148Obj_t* obj,uint8_t vref)
{
    uint8_t tmp,i;
	ads1148RegMUX1_t mux1Temp;
	ads1148_read_register(obj,ADS1148_REG_ADDR_MUX1,(uint8_t*)&mux1Temp,1);
	if(vref>ADS1148_REFSELT_INREF_CON_REF0)vref=ADS1148_REFSELT_INREF_CON_REF0;
    if(vref<=ADS1148_REFSELT_REF1){
        mux1Temp.bits.vrefcon=ADS1148_VREFCON_INREF_OFF;
    }else{
        mux1Temp.bits.vrefcon=ADS1148_VREFCON_INREF_ON;
    }
	mux1Temp.bits.refselt=vref;
    i=5;
    do{
        ads1148_write_register(obj,ADS1148_REG_ADDR_MUX1,(uint8_t*)&mux1Temp,1);
        ads1148_read_register(obj,ADS1148_REG_ADDR_MUX1,(uint8_t*)&tmp,1);
        if(tmp==mux1Temp.mux1)break;
    }while(i--);
}

void ads1148_set_muxcal(ads1148Obj_t* obj,uint8_t muxcal)
{
    
    uint8_t tmp,i;
	ads1148RegMUX1_t mux1Temp;
	ads1148_read_register(obj,ADS1148_REG_ADDR_MUX1,(uint8_t*)&mux1Temp,1);
	if(muxcal>ADS1148_MUXCAL_DVDD_DVSS_DIV_4)muxcal=ADS1148_MUXCAL_DVDD_DVSS_DIV_4;
	mux1Temp.bits.muxcal=muxcal;
    i=5;
    do{
        ads1148_write_register(obj,ADS1148_REG_ADDR_MUX1,(uint8_t*)&mux1Temp,1);
        
        ads1148_read_register(obj,ADS1148_REG_ADDR_MUX1,(uint8_t*)&tmp,1);
        if(tmp== mux1Temp.mux1)break;
        //i++;
    }while(i--);
}

void ads1148_set_data_rate(ads1148Obj_t* obj,uint8_t dr)
{
    uint8_t tmp,i;
    ads1148RegSYS0_t sys0Temp;
	ads1148_read_register(obj,ADS1148_REG_ADDR_SYS0,(uint8_t*)&sys0Temp,1);
	sys0Temp.bits.dr=dr;
    i=5;
    do{
        ads1148_write_register(obj,ADS1148_REG_ADDR_SYS0,(uint8_t*)&sys0Temp,1);
        ads1148_read_register(obj,ADS1148_REG_ADDR_SYS0,(uint8_t*)&tmp,1);
        if(tmp==sys0Temp.sys0)break;
    }while(i--);
}

void ads1148_set_ani_pga(ads1148Obj_t* obj,uint8_t pga)
{
    uint8_t tmp,i;
    ads1148RegSYS0_t sys0Temp;
	ads1148_read_register(obj,ADS1148_REG_ADDR_SYS0,(uint8_t*)&sys0Temp,1);
	sys0Temp.bits.pga=pga;
    
    i=5;
    do{
        ads1148_write_register(obj,ADS1148_REG_ADDR_SYS0,(uint8_t*)&sys0Temp,1);
        ads1148_read_register(obj,ADS1148_REG_ADDR_SYS0,(uint8_t*)&tmp,1);
        if(tmp==sys0Temp.sys0)break;
    }while(i--);
}

void ads1148_set_imag_idac(ads1148Obj_t* obj,uint8_t imag)
{
    uint8_t i,tmp;
    ads1148RegIDAC0_t idac0Temp;
	ads1148_read_register(obj,ADS1148_REG_ADDR_IDAC0,(uint8_t*)&idac0Temp,1);
	idac0Temp.bits.imag=imag;
    
    i=5;
    do{
        ads1148_write_register(obj,ADS1148_REG_ADDR_IDAC0,(uint8_t*)&idac0Temp,1);
        ads1148_read_register(obj,ADS1148_REG_ADDR_IDAC0,(uint8_t*)&tmp,1);
        if(tmp==idac0Temp.idac0)break;
    }while(i--);
}

void ads1148_set_drdy_mode(ads1148Obj_t* obj,uint8_t mode)
{
    uint8_t i,tmp;
    ads1148RegIDAC0_t idac0Temp;
	ads1148_read_register(obj,ADS1148_REG_ADDR_IDAC0,(uint8_t*)&idac0Temp,1);
	idac0Temp.bits.drdyMode=mode;
    i=5;
    do{
        ads1148_write_register(obj,ADS1148_REG_ADDR_IDAC0,(uint8_t*)&idac0Temp,1);
        ads1148_read_register(obj,ADS1148_REG_ADDR_IDAC0,(uint8_t*)&tmp,1);
        if(tmp==idac0Temp.idac0)break;
    }while(i--);
}

void ads1148_set_idac1_pins(ads1148Obj_t* obj,uint8_t i1dir)
{
    uint8_t i,tmp;
    ads1148RegIDAC1_t idac1Temp;
	ads1148_read_register(obj,ADS1148_REG_ADDR_IDAC1,(uint8_t*)&idac1Temp,1);
	idac1Temp.bits.i1dir=i1dir;
    i=5;
    do{
        ads1148_write_register(obj,ADS1148_REG_ADDR_IDAC1,(uint8_t*)&idac1Temp,1);
        ads1148_read_register(obj,ADS1148_REG_ADDR_IDAC1,(uint8_t*)&tmp,1);
        if(tmp==idac1Temp.idac1)break;
    }while(i--);
}

void ads1148_set_idac2_pins(ads1148Obj_t* obj,uint8_t i2dir)
{
    uint8_t i,tmp;
    ads1148RegIDAC1_t idac1Temp;
	ads1148_read_register(obj,ADS1148_REG_ADDR_IDAC1,(uint8_t*)&idac1Temp,1);
	idac1Temp.bits.i2dir=i2dir;
    i=5;
    do{
        ads1148_write_register(obj,ADS1148_REG_ADDR_IDAC1,(uint8_t*)&idac1Temp,1);
        ads1148_read_register(obj,ADS1148_REG_ADDR_IDAC1,(uint8_t*)&tmp,1);
        if(tmp==idac1Temp.idac1)break;
    }while(i--);
}

void ads1148_set_idac12_pins(ads1148Obj_t* obj,uint8_t i1dir,uint8_t i2dir)
{
    uint8_t i,tmp;
    ads1148RegIDAC1_t idac1Temp;
	ads1148_read_register(obj,ADS1148_REG_ADDR_IDAC1,(uint8_t*)&idac1Temp,1);
	idac1Temp.bits.i2dir=i2dir;
    idac1Temp.bits.i1dir=i1dir;
    i=5;
    do{
        ads1148_write_register(obj,ADS1148_REG_ADDR_IDAC1,(uint8_t*)&idac1Temp,1);
        ads1148_read_register(obj,ADS1148_REG_ADDR_IDAC1,(uint8_t*)&tmp,1);
        if(tmp==idac1Temp.idac1)break;
    }while(i--);
}

void ads1148_get_all_register(ads1148Obj_t* obj)
{
	ads1148_read_register(obj,ADS1148_REG_ADDR_MUX0,obj->ads1148Regs.buf,14);
}
//extered api
void ads1148_set_mux0_ex(ads1148Obj_t* obj,uint8_t bcs,uint8_t sp,uint8_t sn)
{
    st_ads1148RegMUX0 mux0Temp;
    mux0Temp.mux0=0x00;
    mux0Temp.bits.bcs=bcs;
    mux0Temp.bits.mux_sp=sp;
    mux0Temp.bits.mux_sn=sn;
	obj->ads1148Regs.regs.regMUX0.mux0=mux0Temp.mux0;
}

void ads1148_set_vbias_ex(ads1148Obj_t* obj,uint8_t bias)
{
    obj->ads1148Regs.regs.regVBIAS.vbias=bias;
}
void ads1148_set_mux1_ex(ads1148Obj_t* obj,uint8_t vrefcon,uint8_t refselt,uint8_t muxcal)
{
    ads1148RegMUX1_t mux1Temp;
    mux1Temp.mux1=0;
    //mux1Temp.bits.clkstat=clkstat;
    mux1Temp.bits.vrefcon=vrefcon;
    mux1Temp.bits.refselt=refselt;
    mux1Temp.bits.muxcal=muxcal;
    obj->ads1148Regs.regs.regMUX1.mux1=mux1Temp.mux1;
}
void ads1148_set_sys0_ex(ads1148Obj_t* obj,uint8_t pga,uint8_t dr)
{
    ads1148RegSYS0_t sys0Temp;
    sys0Temp.sys0=0;
    sys0Temp.bits.pga=pga;
    sys0Temp.bits.dr=dr;
    obj->ads1148Regs.regs.regSYS0.sys0=sys0Temp.sys0;
}
void ads1148_set_idac0_ex(ads1148Obj_t* obj,uint8_t drdyMode,uint8_t imag)
{
    ads1148RegIDAC0_t idac0Temp;
    idac0Temp.idac0=0;
    idac0Temp.bits.drdyMode=drdyMode;
    idac0Temp.bits.imag=imag;
    obj->ads1148Regs.regs.regIDAC0.idac0=idac0Temp.idac0;
    
}

void ads1148_set_idac1_ex(ads1148Obj_t* obj,uint8_t i1dir,uint8_t i2dir)
{
    ads1148RegIDAC1_t idac1Temp;
    idac1Temp.idac1=0;
    idac1Temp.bits.i1dir=i1dir;
    idac1Temp.bits.i2dir=i2dir;
    obj->ads1148Regs.regs.regIDAC1.idac1=idac1Temp.idac1;
}
void ads1148_set_config_ex(ads1148Obj_t* obj)
{
    ads1148_write_register(obj,ADS1148_REG_ADDR_MUX0,obj->ads1148Regs.buf,4);
    ads1148_write_register(obj,ADS1148_REG_ADDR_IDAC0,obj->ads1148Regs.buf+ADS1148_REG_ADDR_IDAC0,2);
}
void ads1148_init_obj_0(void)
{
	ads1148Chip0.chipNm=0;
    ads1148Chip0.pins_sck_set_hight=ads1148_hal_sck_set_hight;
    ads1148Chip0.pins_sck_set_low=ads1148_hal_sck_set_low;
    
    ads1148Chip0.pins_dout_set_hight=ads1148_hal_dout_set_hight;
    ads1148Chip0.pins_dout_set_low=ads1148_hal_dout_set_low;
    
    ads1148Chip0.pins_din_get=ads1148_hal_din_get;
    
    ads1148Chip0.pins_cs_set_hight=ads1148_hal_cs_0_set_hight;
    ads1148Chip0.pins_cs_set_low=ads1148_hal_cs_0_set_low;
    
    ads1148Chip0.pins_start_set_hight=ads1148_hal_start_0_set_hight;
    ads1148Chip0.pins_start_set_low=ads1148_hal_start_0_set_low;
    
    ads1148Chip0.pins_drdy_get=ads1148_hal_drdy_0_get;
    
    ads1148Chip0.pins_init=ads1148_hal_port_init_chip0;
    ads1148Chip0.pins_deinit=ads1148_hal_port_deinit_chip0;
    ads1148Chip0.ads1148_write_read_via_spi=ads1148_hal_write_read_byte;
 
}
void ads1148_init_obj_1(void)
{
	ads1148Chip1.chipNm=1;
    ads1148Chip1.pins_sck_set_hight=ads1148_hal_sck_set_hight;
    ads1148Chip1.pins_sck_set_low=ads1148_hal_sck_set_low;
    
    ads1148Chip1.pins_dout_set_hight=ads1148_hal_dout_set_hight;
    ads1148Chip1.pins_dout_set_low=ads1148_hal_dout_set_low;
    
    ads1148Chip1.pins_din_get=ads1148_hal_din_get;
    
    ads1148Chip1.pins_cs_set_hight=ads1148_hal_cs_1_set_hight;
    ads1148Chip1.pins_cs_set_low=ads1148_hal_cs_1_set_low;
    
    ads1148Chip1.pins_start_set_hight=ads1148_hal_start_1_set_hight;
    ads1148Chip1.pins_start_set_low=ads1148_hal_start_1_set_low;
    
    ads1148Chip1.pins_drdy_get=ads1148_hal_drdy_1_get;
    
    ads1148Chip1.pins_init=ads1148_hal_port_init_chip1;
    ads1148Chip1.pins_deinit=ads1148_hal_port_deinit_chip1;
    ads1148Chip1.ads1148_write_read_via_spi=ads1148_hal_write_read_byte;
}
void ads1148_set_sync(ads1148Obj_t* obj)
{
    uint8_t ret;
	#if ADS1148_SCK_IDLE_STATUE==0
    obj->pins_sck_set_low();
	#else
	obj->pins_sck_set_hight();
	#endif
//delay_us(10);
	obj->pins_cs_set_low();
    //ret=obj->ads1148_write_read_via_spi(ADS1148_CMD_RESET);
    //delay_ms(1);
    ret=obj->ads1148_write_read_via_spi(ADS1148_CMD_SYNC);
    //delay_ms(1);
    ret=obj->ads1148_write_read_via_spi(ADS1148_CMD_SYNC);
	delay_ms(1);
	obj->pins_cs_set_hight();
	delay_us(10);
}
void ads1148_set_ready(ads1148Obj_t* obj)
{
    uint8_t ret;
	#if ADS1148_SCK_IDLE_STATUE==0
    obj->pins_sck_set_low();
	#else
	obj->pins_sck_set_hight();
	#endif
//delay_us(10);
	obj->pins_cs_set_low();
    ret=obj->ads1148_write_read_via_spi(ADS1148_CMD_RESET);
    delay_ms(1);
    ret=obj->ads1148_write_read_via_spi(ADS1148_CMD_SYNC);
    delay_us(10);
    ret=obj->ads1148_write_read_via_spi(ADS1148_CMD_SYNC);
	delay_us(10);
	obj->pins_cs_set_hight();
	delay_us(10);
}
const uint8_t ads1148DefaultBuf[]={1,0,0,0,0,0,0,0,0,0x40,0x90,0xff};

uint8_t  ads1148_init_chip_regs(ads1148Obj_t* obj)
{
	uint16_t t16;
    //float f;
	obj->pins_init();
	ads1148_send_cmd(obj,ADS1148_CMD_RESET);
    //delay_ms(10);
	delay_ms(1);
	//ads1148_set_bcs(obj,ADS1148_BCS_2uA0);
	ads1148_set_vref(obj,ADS1148_REFSELT_INREF);
	ads1148_set_data_rate(obj,ADS1148_SYS0_DR_640SPS);
	ads1148_set_muxcal(obj,ADS1148_MUXCAL_GAIN_CALIB);
	ads1148_set_ani_pga(obj,ADS1148_PGA_1);	
	ads1148_get_all_register(obj);
	if(obj->ads1148Regs.buf[0]!=0x01)return 0;
    __nop();
	ads1148_start_convert(obj);
	//delay_us(5);
	ads1148_waite_convert(obj);
	ads1148_waite_convert(obj);
    t16=ads1148_read_data(obj);
	obj->fullSacle=t16;
	
	ads1148_set_muxcal(obj,ADS1148_VREFCON_INREF_ON);
	ads1148_waite_convert(obj);
	ads1148_waite_convert(obj);
    t16=ads1148_read_data(obj);
	obj->offset=t16;

	ads1148_start_convert(obj);
	ads1148_set_data_rate(obj,ADS1148_SYS0_DR_640SPS);
	ads1148_get_all_register(obj);
	__nop();
    return 1;
}

void ads1148_init_all_obj(void)
{
	ads1148_init_obj_0();
	ads1148_init_obj_1();
}

void ads1148_init_device(void)
{
    uint8_t ret;
    //return;
    ret=ads1148_init_chip_regs(&ads1148Chip0);
    if(!ret)hardStatus.bits.bAdcChip0=0;
    ret=ads1148_init_chip_regs(&ads1148Chip1);  
    if(!ret)hardStatus.bits.bAdcChip1=0;
    
}

void ads1148_pre_sleep(void)
{
    ads1148Chip0.pins_deinit();
    ads1148Chip1.pins_deinit();
	set_port_value_low(ADS1148_CS_1_PORT,ADS1148_CS_1_PIN);
	set_port_value_low(ADS1148_CS_0_PORT,ADS1148_CS_0_PIN);	
	
	allAds1148PinsSta=ADS1148_PINS_UNINIT;
	
	
}

void ads1148_post_sleep(void)
{
	if(allAds1148PinsSta==ADS1148_PINS_UNINIT){
		ads1148Chip0.pins_init();
		ads1148Chip1.pins_init();
		allAds1148PinsSta=ADS1148_PINS_INITED;
	}
}

void ads1148_start_convert(ads1148Obj_t* obj)
{
	obj->pins_start_set_hight();
}

void ads1148_stop_convert(ads1148Obj_t* obj)
{
	obj->pins_start_set_low();
}

void ads1148_waite_convert(ads1148Obj_t* obj)
{
    uint16_t tm=0;
    while(!(obj->pins_drdy_get())){
		asm("nop");
        asm("nop");
        //asm("nop");
        //asm("nop");
        tm++;
        if(tm>5000)break;
    }
    tm=0;
    while(obj->pins_drdy_get())
    {
        asm("nop");
        asm("nop");
        tm++;
        if(tm>5000)break;
    };
    asm("nop");
    asm("nop");
    // asm("nop");
    // asm("nop");
    // asm("nop");
    // asm("nop");
    // asm("nop");
    // asm("nop");    
}

void ads1148_test(void)
{
	volatile uint32_t staTm,eclipsTm,convertNum;
    uint16_t t16;
	
    ads1148_init_chip_regs(&ads1148Chip0);
    ads1148_init_chip_regs(&ads1148Chip1);  
	
	ads1148_set_muxcal(&ads1148Chip0,ADS1148_MUXCAL_AVDD_AVSS_DIV_4);
    
	ads1148_start_convert(&ads1148Chip0);
    delay_us(5);
	staTm=ticker_ms_get();
    convertNum=0x00ul;
	while(1){
        ads1148_waite_convert(&ads1148Chip0);
        //delay_us(5);
        t16=ads1148_read_data(&ads1148Chip0);
		__nop();
		asm("nop");
		eclipsTm=ticker_ms_get()-staTm;
		convertNum++;		
    }
}
