lxp1413801/cs66b-redo/src/driver/lcd-com-seg-clr.h

#ifndef __LCD_SEG_COM_CLR_H__
#define __LCD_SEG_COM_CLR_H__
#ifdef __cplusplus
    extern "C" {
#endif 
	extern uint16_t pLCD[];
	//---------------------------------------------
	//com0 s0-s64
	//LCDDATA0 SEG<15:0>COM0
	#define lcd_data_clr_c0_s00() pLCD[0] &= ~(1<<0)
	#define lcd_data_clr_c0_s01() pLCD[0] &= ~(1<<1)   
	#define lcd_data_clr_c0_s02() pLCD[0] &= ~(1<<2)
	#define lcd_data_clr_c0_s03() pLCD[0] &= ~(1<<3)   
	#define lcd_data_clr_c0_s04() pLCD[0] &= ~(1<<4)
	#define lcd_data_clr_c0_s05() pLCD[0] &= ~(1<<5)   
	#define lcd_data_clr_c0_s06() pLCD[0] &= ~(1<<6)
	#define lcd_data_clr_c0_s07() pLCD[0] &= ~(1<<7)   
	#define lcd_data_clr_c0_s08() pLCD[0] &= ~(1<<8)
	#define lcd_data_clr_c0_s09() pLCD[0] &= ~(1<<9)   
	#define lcd_data_clr_c0_s10() pLCD[0] &= ~(1<<10)
	#define lcd_data_clr_c0_s11() pLCD[0] &= ~(1<<11)   
	#define lcd_data_clr_c0_s12() pLCD[0] &= ~(1<<12)
	#define lcd_data_clr_c0_s13() pLCD[0] &= ~(1<<13)   
	#define lcd_data_clr_c0_s14() pLCD[0] &= ~(1<<14)
	#define lcd_data_clr_c0_s15() pLCD[0] &= ~(1<<15)  	
	//LCDDATA1 SEG<31:16>COM0
	#define lcd_data_clr_c0_s16() pLCD[1] &= ~(1<<0)
	#define lcd_data_clr_c0_s17() pLCD[1] &= ~(1<<1)   
	#define lcd_data_clr_c0_s18() pLCD[1] &= ~(1<<2)
	#define lcd_data_clr_c0_s19() pLCD[1] &= ~(1<<3)   
	#define lcd_data_clr_c0_s20() pLCD[1] &= ~(1<<4)
	#define lcd_data_clr_c0_s21() pLCD[1] &= ~(1<<5)   
	#define lcd_data_clr_c0_s22() pLCD[1] &= ~(1<<6)
	#define lcd_data_clr_c0_s23() pLCD[1] &= ~(1<<7)   
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
	#define lcd_data_clr_c7_s34() pLCD[30] &= ~(1<<2)
	#define lcd_data_clr_c7_s35() pLCD[30] &= ~(1<<3)   
	#define lcd_data_clr_c7_s36() pLCD[30] &= ~(1<<4)
	#define lcd_data_clr_c7_s37() pLCD[30] &= ~(1<<5)   
	#define lcd_data_clr_c7_s38() pLCD[30] &= ~(1<<6)
	#define lcd_data_clr_c7_s39() pLCD[30] &= ~(1<<7)   
	#define lcd_data_clr_c7_s40() pLCD[30] &= ~(1<<8)
	#define lcd_data_clr_c7_s41() pLCD[30] &= ~(1<<9)   
	#define lcd_data_clr_c7_s42() pLCD[30] &= ~(1<<10)
	#define lcd_data_clr_c7_s43() pLCD[30] &= ~(1<<11)   
	#define lcd_data_clr_c7_s44() pLCD[30] &= ~(1<<12)
	#define lcd_data_clr_c7_s45() pLCD[30] &= ~(1<<13)   
	#define lcd_data_clr_c7_s46() pLCD[30] &= ~(1<<14)
	#define lcd_data_clr_c7_s47() pLCD[30] &= ~(1<<15)  	
	//LCDDATA31 SEG<63:48>COM0
	#define lcd_data_clr_c7_s48() pLCD[31] &= ~(1<<0)
	#define lcd_data_clr_c7_s49() pLCD[31] &= ~(1<<1)   
	#define lcd_data_clr_c7_s50() pLCD[31] &= ~(1<<2)
	#define lcd_data_clr_c7_s51() pLCD[31] &= ~(1<<3)   
	#define lcd_data_clr_c7_s52() pLCD[31] &= ~(1<<4)
	#define lcd_data_clr_c7_s53() pLCD[31] &= ~(1<<5)   
	#define lcd_data_clr_c7_s54() pLCD[31] &= ~(1<<6)
	#define lcd_data_clr_c7_s55() pLCD[31] &= ~(1<<7)   
	#define lcd_data_clr_c7_s56() pLCD[31] &= ~(1<<8)
	#define lcd_data_clr_c7_s57() pLCD[31] &= ~(1<<9)   
	#define lcd_data_clr_c7_s58() pLCD[31] &= ~(1<<10)
	#define lcd_data_clr_c7_s59() pLCD[31] &= ~(1<<11)   
	#define lcd_data_clr_c7_s60() pLCD[31] &= ~(1<<12)
	#define lcd_data_clr_c7_s61() pLCD[31] &= ~(1<<13)   
	#define lcd_data_clr_c7_s62() pLCD[31] &= ~(1<<14)
	#define lcd_data_clr_c7_s63() pLCD[31] &= ~(1<<15) 			
#ifdef __cplusplus
    }
#endif
#endif
