lxp1413801/cs66b-redo/src/api/api.h

//file name :api.h
#ifndef __api_h__
#define __api_h__
#ifdef __cplusplus
	extern "C"{
#endif
	#include "../../mcc_generated_files/mcc.h"
    #include <stdint.h>

	#include "sysdata.h"
	#include "ui.h"
	#include "key_menu.h"
	#include "modbus.h"
    #include "at-cmd.h"
	#include "nbiot.h"
	#include "gps.h"

#ifdef __cplusplus
	}
#endif

#endif
//file end
