lxp1413801/cs66b-redo/src/api/key_menu.h

//file name:key_menu.h
#ifndef __key_menu_h__
#define __key_menu_h__

#ifdef __cplusplus
extern "C"{
#endif
	#include <stdint.h>
	#include <stdbool.h>
	extern uint8_t __sys_data_save_write_flash(void);
	#define PSW_SET_DENSITY						36	
	#define PSW_SET_POSE_SIZE					63
	
	#define PSW_SET_EX_PR_TEMP_SHOW				38

	
	#define PSW_SET_BASE_ZERO					56
	//calibration
	#define PSW_CALIB_DIFF_PRESSURE				168
	#define PSW_CALIB_PRESSURE					169
	//Polynomial coefficients(滤波多项式系数)
	#define PSW_SET_POLY_COEFFIC				633
	#define PSW_SET_POLY_COEFFIC_MOD			133
	
	#define PSW_SET_WARN_TYPE					81
	#define PSW_SET_WARN_VALUE					89
	//外压零点和线性
	//#define PSW_SET_EPR_ZERO_LINE             138
	#define PSW_CALIB_PRESSURE_EX0				161
	#define PSW_CALIB_PRESSURE_EX1				162
	
	#define PSW_SET_TMEP_EX0					163
	#define PSW_SET_TMEP_EX1					164
	//外部温度修正
	//#define PSW_SET_ETMEP_ZERO_LINE				136	
	//差压二次修正
	//压力二次修正,精标
	#define PSW_CALIB_DPR_2ND					368
	#define PSW_CALIB_PR_2ND					369
	#define PSW_CALIB_EPR0_2ND					361
	#define PSW_CALIB_EPR1_2ND					362
	
	//设置输出范围
	#define PSW_SET_ILOOP_SCALE					42
	//修正4-20mA输出
	#define PSW_SET_ILOOP_ADJUST				342

	//高度条满刻度对应的值95%还是100%
	#define PSW_SET_BAR_LEVEL_SCALE				98
	#define PSW_SET_WORK_MODE					1888
	//add 
	#define PSW_SET_WAKEUP_PERIOD				13
	#define PSW_SET_RF_SEND_PERIOD				968
	
	//add and modfy 2018.02.08
	#define PSW_SET_BL_ON_TM					39
	#define PSW_SET_LCD_ON_TM					96	
	#define PSW_SET_MODBUS_ID					78
	#define PSW_SHOW_VER						668
	//add at 2015.03.15
	#define PSW_SET_EX_WARN						87
	#define PSW_SET_PDC							6789
	//==============================================================
	//定义菜单,主界面
	#define MENU_HOME							0x00
	#define sub_MENU_HOME_00					0x00
	#define sub_MENU_HOME_01					0x01
	#define sub_MENU_HOME_02					0x02
	//密码验证界面
	#define MENU_PASSWORD						0x10
	#define	sub_MENU_PASSWORD					0x00
	
	#define MENU_PASSWORD_EX					0x11
	#define	sub_MENU_PASSWORD_EX				0x00
	//设置
	#define MENU_SET_PDC						0x12
	#define sub_MENU_SET_PD						0x00
	#define sub_MENU_SET_PC						0x01
	//
	#define MENU_SHOW_PDC						0x13
	#define sub_MENU_SHOW_PDC					0x00
	//设置外部报警值
	#define MENU_SET_WARN_VALUE_EX				0x13
	#define sub_MENU_SET_WARN_VALUE_EX_0		0x00
	#define sub_MENU_SET_WARN_VALUE_EX_7		0x07	
	
	//设置密度	psd=36
	#define MENU_SET_DENSITY					0x20
	#define	sub_MENU_SET_DENSITY				0x00
	#define sub_MENU_SET_SEL_MATTER				0x00
	#define sub_MENU_SET_DENSITY_CUSTOM			0x01
	//设置尺寸 psd=66
	#define MENU_SET_POSE_SIZE					0x30
	#define sub_MENU_SET_POSE					0x00
	#define sub_MENU_SET_L						0x01
	#define sub_MENU_SET_D						0x02
	//设置基础零位	psd=56	
	#define MENU_SET_BASE_ZERO					0x40
	//差压标定,psd=168
	#define MENU_DIFF_CALIB						0x50
	//压力标定,psd=169
	#define MENU_PRESSURE_CALIB					0x60
	//滤波多项式系数psd=133
	#define MENU_POLY_COEFFIC					0x70
	#define sub_MENU_POLY_COEFFIC_a				0x00
	#define sub_MENU_POLY_COEFFIC_b				0x01
	#define sub_MENU_POLY_COEFFIC_c				0x02
	#define sub_MENU_POLY_COEFFIC_d				0x03
	//修改滤波多项式的方式
	//#define PSW_SET_POLY_COEFFIC_MOD			133
	#define MENU_POLY_COEFFIC_MOD				0x71
	#define sub_MENU_POLY_COEFFIC_MOD			0x00	
	//报警方式,psd=6								
	#define MENU_SET_WARN_TYPE					0x80
	#define sub_MENU_SET_WARN_TYPE_0			0x00
	#define sub_MENU_SET_WARN_TYPE_1			0x01
	#define sub_MENU_SET_WARN_TYPE_2			0x02
	#define sub_MENU_SET_WARN_TYPE_3			0x03
	//报警值和回差,psd=16
	#define MENU_SET_WARN_VALUE					0x90
	#define sub_MENU_SET_WARN_VALUE_0			0x00
	#define sub_MENU_SET_WARN_VALUE_1			0x01
	#define sub_MENU_SET_WARN_VALUE_2			0x02
	#define sub_MENU_SET_WARN_VALUE_3			0x03
	#define sub_MENU_SET_WARN_VALUE_4			0x04
	#define sub_MENU_SET_WARN_VALUE_5			0x05
	#define sub_MENU_SET_WARN_VALUE_6			0x06
	#define sub_MENU_SET_WARN_VALUE_7			0x07
 
	#define MENU_PRESSURE_CALIB_EX0				0xa0
	#define MENU_PRESSURE_CALIB_EX1				0xa1
	/*
	//#define MENU_SET_EX_D_PR_ZERO				0xa0
	#define sub_MENU_SET_EPR_CH0_P0				0x00
	#define sub_MENU_SET_EPR_CH0_P1				0x01
	#define sub_MENU_SET_EPR_CH1_P0				0x02
	#define sub_MENU_SET_EPR_CH1_P1				0x03
	*/
	


	//2017.12.07 add
	//休眠唤醒周期
	#define MENU_SET_WAKEUP_PERIOD				0xa3
	#define sub_MENU_SET_WAKEUP_PERIOD			0x00
	//射频发射周期
	#define MENU_SET_RF_SEND_PERIOD				0xa4
	#define sub_MENU_SET_RF_SEND_PERIOD			0x00
	//4-20mA输出范围（差压、压力）
//	#define MENU_SET_DPR_ILOOP_SCALE			0xa5
//	#define	sub_MENU_DPR_ILP_CH0_Lo				0x00
	
	//外部温度修正PSW_SET_ETMEP_ZERO_LINE	=136
	#define MENU_SET_TMEP_EX0					0xa6
	#define sub_MENU_SET_TEMP_P0				0x00
	#define sub_MENU_SET_TEMP_P1				0x01
	
	#define MENU_SET_TMEP_EX1					0xa7
	#define sub_MENU_SET_TEMP_P0				0x00
	#define sub_MENU_SET_TEMP_P1				0x01
	
	//4-20mA修正,psd=112
	#define MENU_SET_ILOOP_ADJUST				0xa8
	#define sub_MENU_SET_ILP_ADJUST_CH0_Lo		0x00
	#define sub_MENU_SET_ILP_ADJUST_CH0_Hi		0x01
	#define sub_MENU_SET_ILP_ADJUST_CH1_Lo		0x02
	#define sub_MENU_SET_ILP_ADJUST_CH1_Hi		0x03	
	
	//精标
	#define MENU_CALIB_DPR_2ND					0xa9
	#define sub_MENU_CALIB_DPR_2ND_P0			0x00
	#define sub_MENU_CALIB_DPR_2ND_P1			0x01
	
	#define MENU_CALIB_PR_2ND					0xaa
	#define sub_MENU_CALIB_PR_2ND_P0			0x00
	#define sub_MENU_CALIB_PR_2ND_P1			0x01
	
	#define MENU_CALIB_EPR0_2ND					0xab
	#define sub_MENU_CALIB_EPR0_2ND_P0			0x00
	#define sub_MENU_CALIB_EPR0_2ND_P1			0x01
	
	#define MENU_CALIB_EPR1_2ND					0xac
	#define sub_MENU_CALIB_EPR1_2ND_P0			0x00
	#define sub_MENU_CALIB_EPR1_2ND_P1			0x01
	
	//4-20mA输出范围,psd=139
	#define MENU_SET_ILOOP_SCALE				0xb0
	#define sub_MENU_SET_ILP_CH0_Lo				0x00
	#define sub_MENU_SET_ILP_CH0_Hi				0x01
	#define sub_MENU_SET_ILP_CH1_Lo				0x02
	#define sub_MENU_SET_ILP_CH1_Hi				0x03
	
	//高度条满刻度对应的值95%还是100%,psd=188	
	#define MENU_SET_BAR_LEVEL_SCALE			0xc0
	#define sub_MENU_SET_BAR_LEVEL_SCALE		0x00
	//显示方式,显示即时值还是平均值
	#define MENU_SET_WORK_MODE					0xf0
	#define sub_MENU_SET_WORK_MODE				0x00
	//是否循环显示外部温度和压力
	#define MENU_SET_EX_PR_TEMP_SHOW			0xf1
	#define sub_MENU_SET_EX_PR_TEMP_SHOW		0x00
	
	
	//背光打开时间
	#define	MENU_SET_BL_ON_TM				0xf2
	#define sub_MENU_SET_BL_ON_TM			0x00
	
	//lcd显示的时间
	#define MENU_SET_LCD_ON_TM				0xf3
	#define sub_MENU_SET_LCD_ON_TM			0x00
	//设置485ID
	#define MENU_SET_MODBUS_ID				0xf4
	#define sub_MENU_SET_MODBUS_ID			0x00	
	//显示版本号
	#define MENU_SHOW_VER					0xf5
	#define sub_MENU_SHOW_VER			0x00		
	typedef union{
		uint8_t t8;
		struct{
			uint8_t upLineMenu:4;
			uint8_t downLineMenu:4;
		}stru;
	}st_homeSubMenu;

	//variable
	extern volatile uint8_t menu;
    extern volatile uint8_t subMenu;
	//extern volatile uint8_t keyValue;
	extern volatile uint16_t passWord;
	extern volatile uint8_t adjLocation;
    extern volatile int32_t adjValue;
	extern  volatile int32_t tmpAdjValue;
	extern  st_float32_m m_floatAdj;
	//
	extern volatile uint8_t  calibRow;
	extern volatile uint8_t  calibCol;	
	//function
	extern void key_process(void);
	//extern void key_process_set_long(void);
	extern void no_operation_save_exit(void);
	//9086504300
	//3045006890

#ifdef __cplusplus
}
#endif
#endif
//file  end
