lxp1413801/cs66b-redo/src/app/main.h

//file name :main.h
#ifndef __main_h__
#define __main_h__
#ifdef __cplusplus
	extern "C"{
#endif
	#include "../../mcc_generated_files/mcc.h"
    #include <stdint.h>
    //extern EventGroupHandle_t threadMainEvent;
	extern volatile uint8_t blShowTime;
    extern volatile uint16_t lcdOnTime;
#ifdef __cplusplus
	}
#endif

#endif
//file end
