lxp1413801/cs66b-redo/src/soc/soc.h

//file name :soc.h
#ifndef __soc_h__
#define __soc_h__
#ifdef __cplusplus
	extern "C"{
#endif
	#include "../../mcc_generated_files/mcc.h"
    #include <stdint.h>
	#include "delay.h"
	#include "ticker.h"
	#include "flash.h"
	
#ifdef __cplusplus
	}
#endif

#endif
