lxp1413801/cs66b-redo/src/app/app.h

//file name :app.h
#ifndef __app_h__
#define __app_h__
#ifdef __cplusplus
	extern "C"{
#endif
	#include "../../mcc_generated_files/mcc.h"
    #include <stdint.h>
	#include "main.h"
	#include "event.h"
	#include "sample.h"
	
#ifdef __cplusplus
	}
#endif

#endif
//file end
