lxp1413801/cs66b-redo/src/driver/lcd.h

#ifndef __lcd_h__
#define __lcd_h__

#ifdef __cplusplus
extern "C"{
#endif
	
	#include <stdint.h>
    #include <stdbool.h>
    #include "lcd-com-seg-clr.h"
    #include "lcd-com-seg-set.h"
	extern uint16_t* pLcdReg;
	#define LCD_PIXEL_REGISTER_SIZE 32
	extern uint16_t pLCD[];
	
    //#define lcd_bl_on() set_portg_value_hight(PIN4);
    //#define lcd_bl_off() set_portg_value_low(PIN4);
    extern const uint8_t  LCDDigitalIndexTable[];
    extern const uint8_t LCDDigitalTableIndexEx[];
    #define lcd_on() LCDCONbits.LCDEN=1;
    #define lcd_off() LCDCONbits.LCDEN=0;
	
	#define lcd_set_com_seg(c,s,d) do{ \
	if(d){lcd_data_set_c##c##_s##s();}else{lcd_data_clr_c##c##_s##s();} \
	}while(0);
	
	//extern void lcd_set_com_seg(uint8_t com,uint8_t s,uint16_t show);
	extern void lcd_disp_all(uint16_t x);
	extern void lcd_init(void);
	
	// extern void lcd_bl_on(void);
	// extern void lcd_bl_off(void);
	
	extern void lcd_disp_refresh(void);
	extern void lcd_show_string_l0(uint8_t* str);
	extern void lcd_show_string_l1(uint8_t* str);
	extern void lcd_show_string(uint8_t* str);
	extern void lcd_clear_all_dp(void);
	extern void lcd_show_dp(uint8_t loc,bool show);
	extern void lcd_disp_logo(bool show);
    
    extern void lcd_disp_level(uint8_t level);
	
	extern void lcd_disp_battary(uint8_t level);
	extern void lcd_disp_rf(uint8_t rssi);
	extern void lcd_disp_light(uint8_t light);
	
	extern void lcd_disp_unit_1st_m(bool show);
	extern void lcd_disp_unit_1st_m3(bool show);
	extern void lcd_disp_unit_t(bool show);
    extern void lcd_disp_unit_2nd_m(bool show);
	extern void lcd_disp_unit_temperature(bool show);
	extern void lcd_disp_unit_2nd_m3(bool show);
	extern void lcd_disp_unit_2nd_m(bool show);
	
	extern void lcd_disp_unit_mpa(bool show);
	#define lcd_disp_clear_buffer() lcd_disp_all(0);
    #define lcd_clear_all() lcd_disp_all(0x00);
	
	extern void lcd_show_string_sm(uint8_t* str);
	extern void lcd_show_string_ex(uint8_t* str);
    extern void lcd_show_dp_sm(uint8_t loc,bool show);
    extern void lcd_disp_dp_loc_sign_sm(bool sig);
    extern void lcd_disp_dp_loc_sm_temperature(bool show);
#ifdef __cplusplus
}
#endif

#endif
//file end
