lxp1413801/cs66b-redo/(commit log)

2017-11-05 lcd driver ok
2017-11-06 adc --->
2017-11-09 ads spi ok
2017-11-13 加入freeRTos之前的关键备份
2017-11-18 add sample
2017-11-24 sample and calc mybe ok
2017-11-25 ui修改前的提交
2017-12-04 小心翼翼的找回了代码
2017-12-09 功耗调试，RG7,RG8无法调整
2017-12-12 加入辅助电路板程序之前的备份
2017-12-12 使用mcc加载adc和uart之前的备份
2017-12-12 使用mcc生成adc和uart的参考代码
2017-12-14 ad421 和报警驱动调试完成
2017-12-18 adc 初略调试
2017-12-24 部分功能调试完成
2017-12-25 部分调试完成2
2017-12-27 修改温度检测之前的备份
2017-12-27 外部温度和内部温度调整完毕
2018-01-03 业经测试前 备份
2018-01-03 ui加入4-20mA修正，未调试
2018-01-04 静压误差修正
2018-01-06 更接近了
2018-01-06 二次标定还差一点点
2018-01-15 基本功能完整版
2018-01-18 修改显示前的备份
2018-01-19 功耗基本调好
2018-01-22 演示样品备份
2018-01-23 add sch
    [CS66.V3.0.SCH.LCD等.sch]
2018-01-25 功耗140uA+0.4s*5.7
2018-02-02 add pads lib
    [CS66.V3.0.SCH.LCD等.sch, esim.dxf, ipex20369.dxf]
2018-02-05 修改pcb外形和mosfet选型
    [CS66.V3.0.SCH.LCD等.pcb, CS66.V3.0.SCH.LCD等.sch, CS66.ZB.V3.0.dxf, esim_mff2.dxf, pcb out line.dxf]
2018-02-06 layout 02
    [CS66.V3.0.SCH.LCD等.pcb, CS66.V3.0.SCH.LCD等.sch, pcb out line_v101.dxf]
2018-02-06 layout 04
    [CS66.V3.0.SCH.LCD等.pcb, CS66.V3.0.SCH.LCD等.sch]
2018-02-08 2018年2月8日再次测试功耗之前备份
    [CS66.V3.0.SCH.LCD等.pcb, CS66.V3.0.SCH.LCD等.sch, esim.dxf, esim_mff2.dxf, ipex20369.dxf, pcb out line.dxf]
2018-02-08 功能梳理1
2018-02-08 加入空闲是lcd不显示功能
2018-02-08 modbus 主程序加入完成
2018-02-09 功耗调试，485控制引脚定义错误的bug
2018-02-09 年前功能完整版
    [CS66.V3.0.SCH.LCD等.pcb, CS66.V3.0.SCH.LCD等.sch, CS66无线扩展板电子元器件清单.xlsx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]
2018-02-23 2018春节以后首次提交
    [CS66.V3.0.SCH.LCD等.pcb, CS66.V3.0.SCH.LCD等.sch]
2018-03-05 节后调试温补前备份
2018-03-08 硬件V33 更改标定前的备份
2018-03-09 加入无线功能之前的备份
2018-03-15 修改液晶关显示关闭，与电池电量关联
2018-05-05 add nbiot frame
